redivo/tcc/doc/project/volume-final/volume-final.pdf

### George Redivo Pinto

# Equipamento para teste de transceptores ethernet

Porto Alegre, Rio Grande do Sul, Brasil

Novembro de 2013

### George Redivo Pinto

# Equipamento para teste de transceptores ethernet

Equipamento para automatizaçao de testes de ˜ equipamentos de rede dotados de transceptores SFP.

Orientador:

### Prof. Marcos Augusto Stemmer

PONTIFÍCIA UNIVERSIDADE CATOLICA DO ´ | RIO GRANDE DO SUL

Porto Alegre, Rio Grande do Sul, Brasil

Novembro de 2013

# Resumo

Durante o desenvolvimento de um sistema, varias etapas de teste s ´ | ao executadas a fim de ˜
garantir o correto funcionamento do mesmo. Em equipamentos destinados a aplicaçoes cr ˜ | íticas,
esses testes sao massivos, na tentativa de garantir que o equipamento, em hip ˜ | otese alguma, fuja ´
do comportamento especificado e esperado, quando em campo.

Equipamentos ethernet switch, alem de interagir com outros equipamentos de rede, como ´ hosts, roteadores e outros switches, podem possuir portas do tipo Small Form-factor Pluggable transceiver (SFP) e interagirem diretamente com eles. Idealmente, o processo de teste de equi-
pamentos com portas SFP deve incluir testes de inserçao e remoç ˜ | ao, o que, por sua vez, necessita ˜
de intervençao f ˜ | ísica. Essa intervençaõ e geralmente manual, o que acaba provocando um alto ´
índice de erros.
Nesse contexto, este Trabalho de Conclusao de Curso prop ˜ | oe um equipamento capaz de ˜
viabilizar a automatizaçao dos testes de SFP. Essa plataforma inclui um m ˜ | odulo de injeç ´ | ao de ˜
falhas. Em mais detalhes, a plataforma sera capaz de fazer a inserç ´ | ao e remoç ˜ | ao de dois SFPs ˜
diferentes em uma mesma porta do ethernet switch, alem da injeç ´ | ao de falhas no barramento I ˜

2C,
tudo controlado por comunicaçao serial, possibilitando assim a automatizaç ˜ | ao do processo como ˜
um todo.

A soluçao proposta foi validada em um equipamento de rede fornecido pela empresa Data- ˜
com Telematica. Neste sentido, foi realizado uma s ´ | erie de experimentos visando a validaç ´ | ao da ˜
soluçao proposta. ˜

# Abstract

During a product design, several steps are performed to guarantee the correct product operation. In equipment designed for critical applications, these tests are massively stressed, trying to guarantee that the equipment works according to specifications.

Ethernet switches, also may interact with other network equipment, like hosts, routers and another switches, could have Small Form-factor Pluggable transceiver (SFP) ports and may interact directly with these equipment. Ideally the test process on SFP ports must include SFP insertion and removing tests, which requires a physical intervention. This intervention, in general, is done manually, inserting a high human error probability.

This paper proposes an infrastructure to turn automatic SFP tests feasible, including a fault injection module. Detailing it, this equipment is capable to perform the insertion and removing of two different SFPs in a same ethernet switch’s port. It is also capable to do fault injection on I

2C bus, all of it controlled by a serial communication, turning possible the automation of this test process.

This solution was validated in a network equipment provided by Datacom Telematica. To ´ validate it, several tests was performed to guarantee the functionality of the features proposed in this paper.

# Sumario ´

Lista de Tabelas

Lista de Figuras

Lista de Siglas | p. 8
1 Introduçaõ | p. 9
2 Fundamentaçao Te ˜ | orica ´ | p. 12
2.1 I²C | | p. 12
2.2 Portas Ethernet | | p. 13
2.2.1 | Modelo OSI | | p. 13
2.2.2 | Portas físicas | | p. 14
2.2.3 | Configuraçao | ˜ | p. 15
2.3 SFPs | | p. 17
2.3.1 | Tipos de SFPs | | p. 17
2.3.2 | PHY | | p. 18
2.3.3 | Dispositivos Internos | | p. 20
2.4 Modelos de Falha | | p. 20
2.5 Tipos de Teste | | p. 22
2.6 Mecanismos de Injeçao de Falhas | ˜ | p. 23

3 Soluçao Proposta ˜ | | p. 26
3.1 Multiplexaçao de SFPs | ˜ | p. 27
3.2 Modulo de Injeç ´ | ao de Falhas | ˜ | p. 28
3.3 Implementaçao | ˜ | p. 28
3.3.1 | Arquitetura de Hardware | | p. 29
3.3.2 | Arquitetura de Sofware | | p. 34
4 Validaçao e Avaliaç ˜ | aõ | p. 38
4.1 Teste das PCBs | | p. 39
4.1.1 | Teste de Montagem | | p. 39
4.1.2 | Teste Funcional | | p. 39
4.2 Teste de Integraçao | ˜ | p. 39
4.2.1 | Multiplexaçao | ˜ | p. 40
4.2.2 | Injeçao de Falhas | ˜ | p. 40
4.3 Analise dos Resultados | ´ | | p. 41
5 Consideraçoes Finais ˜ | p. 42
Referencias Bibliogr ˆ | aficas ´ | p. 43

# Lista de Tabelas

2.1 Parametros de configuraç ˆ | ao de portas ˜ | ethernet | | p. 15

# Lista de Figuras

2.1 Barramento I²C | | p. 13
2.2 Comunicaçaõ pass-through entre switch e SFP | | p. 18
2.3 Comunicaçao atrav ˜ | es de um PHY combo | ´ | | p. 19
2.4 Comunicaçao atrav ˜ | es de um PHY interno ao SFP el ´ | etrico | ´ | p. 19
3.1 Operaçao normal entre ˜ | switch e SFP | | p. 26
3.2 Operaçao com intervenç ˜ | ao do ATE entre ˜ | switch e SFP | | p. 26
3.3 Visao geral do ATE | ˜ | | | p. 27

3.4 Monitoramento e injeçao de falhas nos acessos I ˜

| | 2C | | p. 29
3.5 Projeto de hardware | | p. 30
3.6 Imagem da HS-PCB | | p. 31
3.7 Imagem da LS-PCB | | p. 32
3.8 Imagem de blocos da LS-PCB | | p. 33

3.9 Ligaçao do I ˜

2C entre ATE, SFP e ethernet switch | | p. 33
3.10 Arquitetura do software | | p. 35

8

# Lista de Siglas

TCC Trabalho de Conclusao de Curso ˜

SFP Small Form-factor Pluggable

XFP 10 Gigabit Small Form-factor Pluggable

ATE Automatic Test Equipment, equipamento de teste automatico ´

MDIX Medium Dependent Interface crossover, interface cruzada dependente de mídia

MSA Multi-Source Agreement, acordo multi-fonte

OSI Open Systems Interconnection, sistema aberto de interconexoes ˜

CI Circuito Integrado

DD Digital Diagnostics, diagnosticos digitais

PCB Printed Circuit Board, placa de circuito impresso

HS-PCB High Speed PCB, PCB de alta velocidade

LS-PCB Low Speed PCB, PCB de baixa velocidade

BIST Built-In Self Tests

ACK acknowledgement

SoC System on Chip

ARM-DEV-KIT ARM Devetopment Kit, Kit de desenvolvimento ARM

SerDes Serializador/Desserializador

SGMII Serial Gigabit Media Independent Interface, Interface serial gigabit independente de

mídia

9

# 1 Introduçaõ

Com o aumento da complexidade dos sistemas atuais, a tarefa de teste e algo de extrema ´

importancia. Um teste, em linhas gerais, ˆ | e uma atividade na qual uma ou mais entradas s ´ | aõ
injetadas em um dado sistema e suas saídas sao analisadas, a fim de encontrar discrep ˜ | ancias ˆ

entre o comportamento especificado e o comportamento real do sistema.

Dependendo das características e dimensoes de um sistema, a tarefa de desenvolvimento ˜

pode se tornar bastante complexa (DELAMARO; MALDONADO; JINO, 2007), o que torna a

atividade de teste de um projeto algo crucial para garantir o bom funcionamento de um produto.

O teste pode ser feito em varios n ´ | íveis e estagios de produç ´ | ao de um sistema. Desde testes ˜
dos circuitos integrados (CIs) que compoe o sistema at ˜ | e testes em campo, utilizando ´ | Built-In Self
Tests, BISTs. E desej ´ | avel que um problema seja descoberto no est ´ | agio mais b ´ | asico poss ´ | ível, pois
o custo da resoluçao de um problema sobe conforme o n ˜ | ível em qual ele foi encontrado (WANG;

WU; WEN, 2006).

O teste de um projeto pode ser dividido em varias etapas. Entre elas est ´ | ao: (1) teste funcional, ˜
onde o projeto e testado a fim de garantir a conformidade com sua especificaç ´ | | | ao comportamental ˜

e (2) teste comportamental, onde o alvo do teste e excitado de forma a simular o uso real do equi- ´

pamento ou sistema, tentando encontrar falhas, para que elas sejam corrigidas antes do projeto

ser dado como pronto. Os estímulos do teste podem ser introduzidos manualmente, com uma

pessoa interagindo ativamente com o alvo do teste. Outra forma, e utilizando componentes auto- ´

matizadores de teste, onde um elemento pre programado interage com o alvo do teste, inserindo ´

os estímulos (HSUEH; TSAI; IYER, 1997). Esses componentes sao chamados equipamento de ˜

teste automatico, ATE, do ingl ´ | esˆ Automatic Test Equipment.
Existem tambem testes envolvendo injeç ´ | ao de falhas, no qual o equipamento ou sistema ˜ | é

10

testado em condiçoes anormais. Os testes com injeç ˜ | ao de falhas s ˜ | ao utilizados para observar o ˜
comportamento do alvo do teste em uma situaçao de falha tanto do pr ˜ | oprio projeto, quanto de ´

outros subsistemas envolvidos. Com os dados obtidos nos testes com injeçao de falhas pode-se ˜

medir, por exemplo, a robustez do projeto e se ele responde da forma esperada quando encontra

um estado de falha. As falhas podem ser introduzidas em diversos níveis, desde níveis mais

baixos, como curto circuitos, ate o n ´ | ível de usuario, como inserç ´ | ao de um valor inv ˜ | alido em um ´
campo de entrada. Esse tipo de teste e muito ´ | util em aplicaç ´ | oes cr ˜ | íticas, pois essas tem de se
manter sempre ativas, muitas vezes implementando modulos de toler ´ | ancia a falhas para evitar a ˆ
indisponibilidade do sistema. Aplicaçoes cr ˜ | íticas sao, por exemplo, sistemas de navegaç ˜ | ao de ˜

aeronaves, ou sistemas automatizados de controle de metro, os quais nunca podem parar, pois ˆ

causariam um prejuízo muito grande.

Os testes podem ser manuais ou automaticos, dependendo dos requerimentos do teste. Tes- ´

tes manuais tem diversas desvantagens quando comparados a testes autom ` | aticos, como menor ´

velocidade de execuçao do teste, tempo gasto com a aprendizagem de um novo procedimento, ˜

falta de consistencia e possibilidade de erro humano na execuç ˆ | ao das tarefas. Embora muitas das ˜

desvantagens sejam relacionadas apenas a requisitos temporais, a possibilidade de erro durante

a execuçao do roteiro de teste est ˜ | a relacionada ´ | a credibilidade do teste. Se, durante a execuç ` | aõ

de um teste manual, algum passo do roteiro for pulado, adicionado, ou executado de forma er-

rada, o teste pode apresentar resultados invalidos, tanto falsos positivos quanto falsos negativos. ´

Por todos esses motivos, o esforço gasto em automatizaçao de testes vem sendo cada vez maior, ˜

assim, os recursos humanos podem ser investidos em outras atividades mais produtivas, como o

aprimoramento dos casos de teste, ao inves de serem gastos na execuç ´ | ao dos mesmos. ˜

A atividade de teste, alem se ser a base um sistema livre de falhas, ajuda a desenvolver ´

estatísticas de rendimento do processo (WANG; WU; WEN, 2006). Assim, dependendo do nível

de detalhamento e poss ´ | ível identificar falhas de processo do projeto como um todo, desde a fase
de especificaçao at ˜ | e a fase de produç ´ | ao. ˜

Com o objetivo de flexibilizar o uso, alguns equipamentos de rede possuem portas de comunicaçaõ

com conector para a inserçao de um transceptor ( ˜ | transceiver) externo. Um transceiver, do ponto
de vista de redes de dados, e um dispositivo da camada f ´ | ísica, capaz de transmitir e receber da-
dos, fazendo a conversao dos sinais (sinais el ˜ | etricos em ´ | opticos, por exemplo) e/ou a convers ´ | aõ
da interface de comunicaçao. Com diferentes ˜ | transceivers, e poss ´ | ível, por exemplo, uma mesma

11

porta de comunicaçao ser utilizada com fibra ˜ | optica ou conetor RJ45. ´
A configuraçao aplicada na porta deve ser compat ˜ | ível com o transceptor inserido na mesma,
para evitar comportamentos inesperados. No entanto, devido a possibilidade de variadas configuraç ` | oes ˜
e modelos de transceptores, a configuraçao se torna algo extremamente delicado e suscet ˜ | ível a

erros.

Certos equipamentos sao capazes de configurar automaticamente a porta, baseando-se nas ˜

informaçoes obtidas do transceptor. A dificuldade da autoconfiguraç ˜ | aõ e agravada pelo fato de ´
existir uma grande gama de combinaçoes entre configuraç ˜ | ao e modelo de transceptor. Al ˜ | em´
disso, existem casos onde equipamentos sao logicamente empilhados ( ˜ | stacking¹
).

Em um ambiente de staking, podem existir diversos equipamentos com características dife-

rentes, o que dificulta a configuraçao destes. ˜

Durante o processo de teste dos trasnceivers, se faz necessario a conex ´ | ao e/ou desconex ˜ | aõ

física dos mesmos, geralmente manual, trazendo os riscos e desvantagens ja citadas anterior- ´

mente. A automatizaçao desses procedimentos resulta em um grande acr ˜ | escimo na produtivi- ´

dade e confiabilidade do teste, porem isso introduz um elemento a mais no ambiente de testes, ´

um ATE.

Este TCC propoe um soluç ˜ | ao baseada em ˜ | hardware e software que permite a automatizaçaõ

de testes de equipamentos ethernet dotados de transceptores SPFs. Como estudo de caso foram

utilizados transceptores SPFs em switches ethernet.

1Do ponto de vista de equipamentos de rede, quando monta-se um ambiente onde varios equipamentos s ´ | aõ
ligados uns aos outros, de forma a se tornarem virtualmente um equipamento so, com capacidade somada e controle ´ centralizado, denomina-se um ambiente stacking.

12

2 | Fundamentaçao Te ˜ | orica ´
Dentro do universo de redes de dados existem inumeras distinç ´ | oes entre tipos de equipamen- ˜
tos, funcionalidades e configuraçoes. O cen ˜ | ario escolhido para o estudo ´ | e o de equipamentos ´

ethernet dotados de portas SFPs.

## 2.1 I²C

Desenvolvido pela Philips (atual NXP), nos anos 80, a comunicaçao I ˜

2C e uma comunicaç ´ | aõ

em barramento, que utiliza dois fios para trafego de dados serial. Usando uma estrutura mestre- ´

escravo, e poss ´ | ível a comunicaçao entre v ˜ | arios dispositivos utilizando apenas dois fios, em dreno ´
aberto: um fio de clock e um de dados, chegando a taxa de transfer ` | encia de 3,4Mbps (I2C- ˆ
BUS.ORG, 2013). Devido a simplicidade e versatilidade de implementaç ` | ao, o I ˜

2C e largamente ´

usado em comunicaçoes simples que n ˜ | ao exigem alta taxa de transfer ˜ | encia de dados. ˆ

A comunicaçao I ˜

2C se da atrav ´ | es de um barramento onde ficam conectados um dispositivo ´
mestre e ate 127 dispositivos escravos (figura 2.1). O dispositivo mestre n ´ | ao possui endereço. ˜

Os dispositivos escravos possuem um endereçamento de 7 bits, podendo endereçar 127 dispo-

sitivos. O endereço 0 e utilizado como endereço geral, uma especie de endereço de ´ | broadcast.

Existe tambem um modo de endereçamento de 10 bits, o que aumenta a quantidade de endereços ´

disponíveis.

Em linhas gerais, a comunicaçao se d ˜ a da seguinte forma: (1) mestre informa ao barramento ´

que deseja se comunicar com um dispositivo informando seu endereço; (2) o dispositivo escravo

responde um acknowledgement (ACK); (3) mestre informa registrador interno com o qual deseja

se conectar; (4) escravo responde dado referente ao registrador interno, em caso de leitura, ou

13

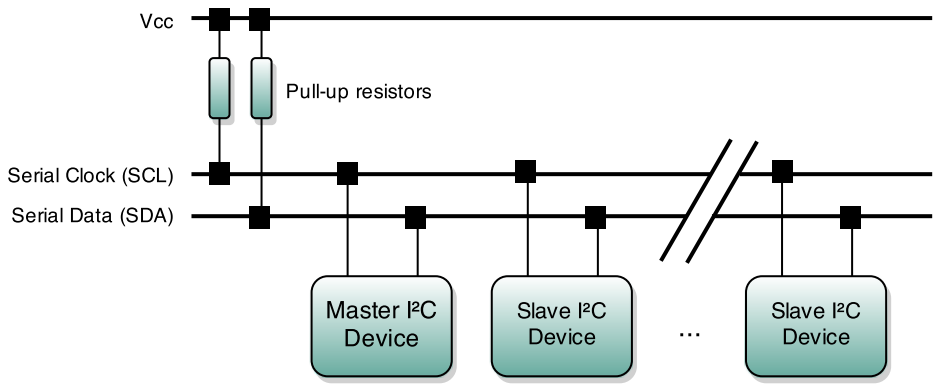
[picture p7: figure]

Figura 2.1: Barramento I²C

faz a atribuiçao em caso de escrita. ˜

## 2.2 Portas Ethernet

A ethernet e uma arquitetura de rede de dados largamente utilizada. Ela ´ | | e normatizada pela ´

IEEE 802.3, que descreve todos os detalhes da arquitetura. As portas de um equipamento ether-

net podem ser de tipos variados e ter configuraçoes distintas. Esta sess ˜ | ao destina-se a detalhar as ˜

principais características das portas ethernet.

### 2.2.1 Modelo OSI

O Modelo OSI (Open Systems Interconnection, sistema aberto de interconexoes) ˜ | e uma das ´
mais antigas e mais usadas arquiteturas de comunicaçao entre m ˜ | aquinas. Este modelo divide a ´
comunicaçao em 7 camadas hier ˜ | arquicas. Cada camada tem uma funç ´ | ao bem definida dentro ˜

da comunicaçao e consegue se comunicar apenas com as camadas adjacentes. Essa propriedade ˜

modulariza a comunicaçao de forma a diminuir a complexidade da comunicaç ˜ | | ao como um todo. ˜

As camadas sao divididas da seguinte maneira: ˜

Aplicaçaõ
A camada de aplicaçaõ e a camada de mais alto n ´ | ível. E nela que ficam os ´ | softwares como

navegadores de internet e clientes de e-mail.

14

Apresentaçaõ

Esta camada e respons ´ | avel pela formataç ´ | ao e convers ˜ | ao dos dados. ˜

Sessaõ

A camada de sessao gerencia o fluxo de dados, sendo respons ˜ | avel por tratamento de erros ´

dessa natureza.

Transporte
E respons ´ | avel pela entrega e recebimento dos dados, tentando garantir a confiabilidade de ´

transmissao. ˜

Rede

Esta camada faz o roteamento dos pacotes, escolhendo a melhor rota, baseando-se em

metricas como congestionamento e custo do caminho. ´

Enlace

A camada de enlace e o elo entre a camada f ´ | ísica e a camada de rede. Ela e respons ´ | avel ´

pela configuraçao de fluxo de dados e pela topologia de rede. ˜

Física

Esta e a camada de mais baixo n ´ | ível, onde os sinais logicos e el ´ | etricos s ´ | ao convertidos e ˜

enviados.

Este trabalho atua nas duas camadas de nível mais baixo: camada física e de enlace.

### 2.2.2 Portas físicas

As portas de um equipamento ethernet servem para fazer a ligaçao entre dois dispositivos em ˜

uma rede ethernet. Diversos conectores ja foram usados em aplicaç ´ | oes ˜ | ethernet e o mais comum
e o conector RJ45, o qual ´ | e usado para fazer a ligaç ´ | ao com um par trançado ˜

1
. Com o desen-
volvimento da tecnologia optica, os cabos de fibra ´ | optica vem se popularizando, principalmente ´
em aplicaçoes de alta frequ ˜ | encia e aplicaç ˆ | oes de longa dist ˜ | ancia. A fibra ˆ | optica, por usar a luz, ´
1Par trançado e um tipo de cabeamento onde dois fios, contendo sinais diferenciais, s ´ | | | | ao enrolados um ao redor ˜
do outro, a fim de diminuir a suscetibilidade a interfer ` | encias eletromagn ˆ | eticas. Cabos ´ | ethernet do padrao CAT 6, ˜
por exemplo, contem 4 pares trançados.

15

pode trabalhar em frequencias muito altas, tem baixo n ˆ | ível de perda de sinal e suscetibilidade
a interferencia. Por outro lado, o cabo el ˆ | etrico, apesar de n ´ | ao possuir tantas vantagens, chega a ˜
1Gbps e distancias de at ˆ | e 100 metros por um custo bem inferior ´ | a fibra ` | optica. ´

Como foi citado no capítulo 1, existem equipamentos com portas as quais seu conector naõ

e nem para fibra ´ | optica, nem para RJ45, mas sim conector para algum ´ | transceiver. Desta forma,

uma mesma porta pode ser usada com cabeamento de fibra optica ou par trançado, dependendo ´

do transceptor conectado. Em aplicaçoes ˜ | ethernet, os transceptores mais comumente usados saõ
os SFPs e XFPs. SFPs sao geralmente usados para aplicaç ˜ | oes de rede ˜ | Gigabit Ethernet, enquanto
XFPs sao usando para aplicaç ˜ | oes de 10 ˜ | Gigabit Ethernet.

### 2.2.3 Configuraçaõ

Cada porta ethernet deve receber uma serie de configuraç ´ | oes para que tenha uma operaç ˜ | aõ
estavel. Essas configuraç ´ | oes ditam desde o ˜ | bit rate, ate configuraç ´ | oes de invers ˜ | ao de TX e RX. ˜
Os parametros mais comuns de configuraç ˆ | ao de uma porta ˜ | ethernet estao listados na tabela 2.1. ˜
Tabela 2.1: Parametros de configuraç ˆ | ao de portas ˜ | ethernet
Parametro ˆ | Descriçaõ
Velocidade | 1 Informa a velocidade do trafego na porta. ´
Speed Capabilities | Informa as configuraçoes de velocidade poss ˜ íveis para a porta.²
Duplex | 1 Informa se a conexaõ é Full Duplex ou Half Duplex.
Duplex Capabilities | Informa as configuraçoes de ˜ duplex possíveis para a porta.²
Negociaçaõ | Informa se os parametros de ˆ duplex e velocidade serao forçados ou ne- ˜ gociados, utilizando as capabilities.
MDIX | Informa se a ligaçao de TX e RX est ˜ a normal, invertida ou se ser ´ a con- ´ figurada automaticamente.³
Habilitaçaõ | Informa se a porta esta habilitada ou desabilitada. ´
1Configuraçao v ˜ | alida apenas quando auto negociaç ´ | ao est ˜ | a desabilitada. ´
2Configuraçao v ˜ | alida apenas quando auto negociaç ´ | ao est ˜ | a habilitada. ´
3MDIX automatico funciona apenas quando auto negociaç ´ | ao est ˜ | a habilitada, caso contr ´ | ario o MDIX per- ´
manece com o status anterior.
Existe ainda uma configuraçao referente ao protocolo de comunicaç ˜ | ao usado entre a camada ˜
física e a camada de enlace. Essa configuraçao geralmente ˜ | e transparente para o usu ´ | ario da ´
porta, ao contrario das configuraç ´ | oes listadas na tabela 2.1. A escolha de qual protocolo utilizar ˜

16

depende do protocolo utilizado pelo dispositivo parceiro ligado a porta. Dois protocolos nor- `

malmente sao utilizados: (1) SerDes (Serializador/Desserializador) e (2) SGMII ( ˜ | Serial Gigabit

Media Independent Interface)

2
. Os dois sao protocolos de comunicaç ˜ | ao serial. O protocolo Ser- ˜
Des e geralmente utilizado em conex ´ | oes diretas, onde n ˜ | ao existe um PHY intermedi ˜ | ario (ver sub ´
sessao 2.3.2), caso contr ˜ | ario utiliza-se o protocolo SGMII. ´
As configuraçoes a serem feitas dependem de diversos fatores como aplicaç ˜ | ao, tipo de cabo, ˜
tipo de conexao e suporte ˜ | as configuraç ` | oes por parte das duas pontas da conex ˜ | ao, da porta e, em ˜
caso de uso de transceivers, suporte as configuraç ` | oes por parte dos ˜ | transceivers.
Devido a essa variabilidade, a parte do sistema que executa as configuraçoes ˜ | e extremamente ´
sensível. Em casos onde existe um transceptor na porta, essa sensibilidade e acentuada, pois al ´ | em´
do suporte de configuraçao das portas dos dois lados da conex ˜ | ao, a configuraç ˜ | ao ainda precisa ˜
ser coerente com o transceptor. Durante o funcionamento do equipamento, e poss ´ | ível trocar o

transceiver de uma determinada porta por outro com características diferentes, o que faz com

que configuraçoes diferentes devam ser escolhidas e aplicadas, dependendo das especificaç ˜ | oes ˜

do transceptor.

Exitem ainda equipamentos com portas chamadas portas combo. Essas portas sao replicadas. ˜

Para flexibilizar as aplicaçoes do equipamento, cada porta combo ˜ | e dotada de um conector SFP ´
e um conector RJ45, porem os dois conectores n ´ | ao podem ser usados simultaneamente. Essas ˜
portas sao configuradas de maneira completamente diferente em cada meio (meio ˜ | optico, SFP, e ´
meio eletrico, RJ45), o que torna a configuraç ´ | ao de portas combo ainda mais sens ˜ | ível a erros.
Com essa dinamica, a configuraç ˆ | ao de portas pode se tornar algo complexo, em especial em ˜
casos onde o equipamento e provido de um m ´ | odulo de auto configuraç ´ | ao. Essas caracter ˜ | ísticas
tornam o teste de configuraçao e troca de transceptores uma tarefa cr ˜ | ítica, pois existem inumeras ´
combinaçoes de configuraç ˜ | ao poss ˜ | íveis, tornando o teste uma tarefa longa e um bom alvo para

ser automatizado.

2SGMII e um protocolo de comunicaç ´ | ao criado pela Cisco com o objetivo de viabilizar a utilizaç ˜ | ao entre a ˜
camada MAC e PHYs 10/100/1000 com o mínimo possível de perda de sinal (CISCO SYSTEMS, 2005).

17

## 2.3 SFPs

SFP (Small Form-factor Pluggable) e um tipo de transceptor, um modelo de tamanho f ´ | ísico
pequeno, utilizado para conexoes de baixa e m ˜ | edia velocidade (abaixo de 10Gbps). Existem ´
diversos tipos de SFPs. Os SFPs dividem-se basicamente em SFPs eletricos e SFPs ´ | opticos, os ´

quais mais comumente usam conectores RJ45 e LC, respectivamente.

Os SFPs sao descritos por dois MSA ( ˜ | Multi-Source Agreement), INF-8074 e SFF-8472.
Esses documentos definem como devem ser as características mecanicas, el ˆ | etricas e l ´ | ogicas, ´
como dimensoes, imped ˜ | ancias e endereçamento das informaç ˆ | oes. Como esses documentos n ˜ | aõ

sao uma norma oficial, apenas um acordo entre alguns dos grandes fabricantes desses equipa- ˜

mentos, existe a possibilidade de alguns modelos nao seguirem as recomendaç ˜ | oes. Isso torna ˜
a configuraçao das portas envolvendo SFPs mais dif ˜ | ícil e perigosa. SFPs que nao seguem as ˜

especificaçoes dos MSAs podem apresentar comportamentos indefinidos. Por esse motivo al- ˜

guns fabricantes de equipamentos que usam SFPs tem uma política de homologaçao de SFPs e ˜

bloqueio de SFPs nao homologados. ˜

Cada SFP possui pelo menos um dispositivo interno acessado por I²C.

O dispositivo basico, acessado pelo endereço 0x50 (SFF COMMITTEE, 2013), comum ´ | à
todos os SFPs, e um bloco de mem ´ | oria onde ficam gravadas as informaç ´ | oes sobre o SFP. Esse ˜
bloco de memoria guarda informaç ´ | oes como nome do fabricante, n ˜ | umero de s ´ | erie, tipo conector, ´
taxa maxima de transmiss ´ | ao e outros dados referentes ao SFP, bem como c ˜ | odigos de checagem. ´
Alem do dispositivo b ´ | asico, o SFP pode conter outros dispositivos adicionais acessados por ´

I

2C, tais como modulo de diagn ´ | ostico digital (DD, ´ | Diagital Diagnostics), e PHY interno do SFP.
Cada dispositivo e acessado atrav ´ | es de um endereço I ´

2C diferente.

### 2.3.1 Tipos de SFPs

Entre todos os modelos de SFPs existem dois grandes grupos: os SFPs eletricos e os SFPs ´

opticos. Dentro desses grupos existem outras subdivis ´ | oes. As divis ˜ | oes s ˜ | ao feitas a fim de separar ˜
os SFPs por taxa de transferencia, possibilidade de negociaç ˆ | ao, ˜ | capabilities e, especificamente
para SFPs opticos, existem divis ´ | oes de comprimento de onda e dist ˜ | ancia m ˆ | axima (pot ´ | encia) do ˆ

18

laser.

Os variados tipos de SFPs necessitam de configuraçoes diferentes, alguns suportam mais ˜

configuraçoes que outros. Isso faz com que, em caso de auto configuraç ˜ | ao, de alguma forma, ˜
o equipamento que esta hospedando o SFP deva conseguir descobrir informaç ´ | oes pertinentes ˜
as configuraç ` | oes e fazer a correta aplicaç ˜ | ao dessas configuraç ˜ | oes. Essas informaç ˜ | oes est ˜ | ao dis- ˜

postas em um memoria dentro do SFP, acessada por I ´

| | | 2C, cujo mapeamento e descrito pelos ´

documentos INF-8074 e SFF-8472 (SFF COMMITTEE, 2001) (SFF COMMITTEE, 2013).

A maioria dos SFPs opticos com taxa de transfer ´ | encia na casa de 1Gbps fazem uma passa- ˆ
gem direta (pass-through) na comunicaçao com o ˜ | switch, atraves do modo SerDes (figura 2.2), ´
utilizando o PHY (melhor detalhado em 2.3.2) do proprio ´ | switch para fazer as configuraçoes, ˜
apenas transformando o sinal optico em sinal el ´ | etrico e vice-versa. J ´ | a os SFPs el ´ | etricos e alguns ´
100Mbps opticos possuem um PHY interno, o qual deve ser configurado com os par ´ | ametros ˆ
vistos na tabela 2.1, alem da configuraç ´ | ao do pr ˜ | oprio ´ | switch.

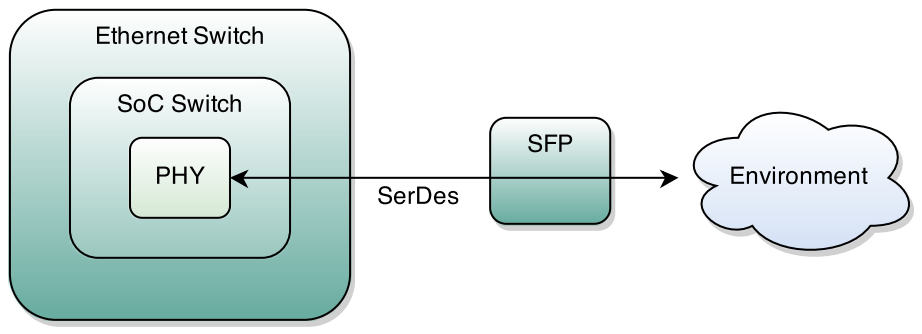
[picture p8: figure]

Figura 2.2: Comunicaçaõ pass-through entre switch e SFP.

### 2.3.2 PHY

PHY, do inglesˆ physical, do ponto de vista de redes ethernet, e um dispositivo que trabalha ´

na camada física do modelo OSI, capaz de fazer a conversao de sinais anal ˜ | ogicos em digitais, e ´
vice-versa, enviando e recebendo frames ethernet (PHY, 2013). Alem das configuraç ´ | oes citadas ˜
na tabela 2.1, alguns PHYs dispoes de configuraç ˜ | oes e informaç ˜ | oes mais espec ˜ | íficas, como tipo
de mídia, protocolo de comunicaçao e invers ˜ | ao de trilhas. ˜

Esses dispositivos podem ser um CI separado, ou estar integrado em um CI com mais funci-

19

onalidades. O trafego de uma porta ´ | ethernet pode passar por mais de um PHY, mesmo antes de

sair do equipamento origem. Isso acontece em casos de portas combo, por exemplo, onde alem´

de o trafego passar pelo PHY integrado no SoC ( ´ | System on Chip) do switch, pode passar por mais
um PHY, que e respons ´ | avel de escolher qual meio (porta el ´ | etrica ou porta SFP) ser ´ | a enviado ou, ´
em caso de recebimento, qual porta sera escutada, como mostra a figua 2.3. Outro caso onde h ´ | á
mais de um PHY envolvido, e em ocasi ´ | oes em que usamos SFPs com PHY embarcado (figura ˜
2.4), como explicado na sessao 2.3.1, onde esse PHY ˜ | e acessado atrav ´ | es de uma comunicaç ´ | aõ

I

2C com o SFP. Nesses casos existe um PHY para fazer a comunicaçao do ˜ | switch ate o SFP e ´
outro PHY, embarcado no SFP, que faz a comunicaçao at ˜ | e o outro lado da conex ´ | ao. ˜

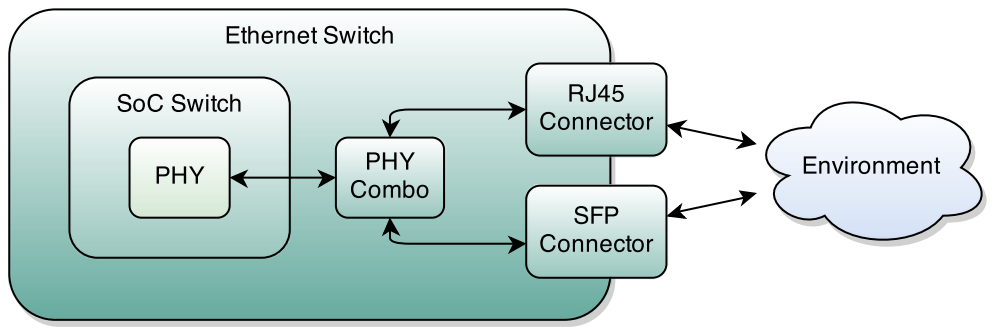
[picture p9: figure]

Figura 2.3: Comunicaçao atrav ˜ | es de um PHY combo. ´

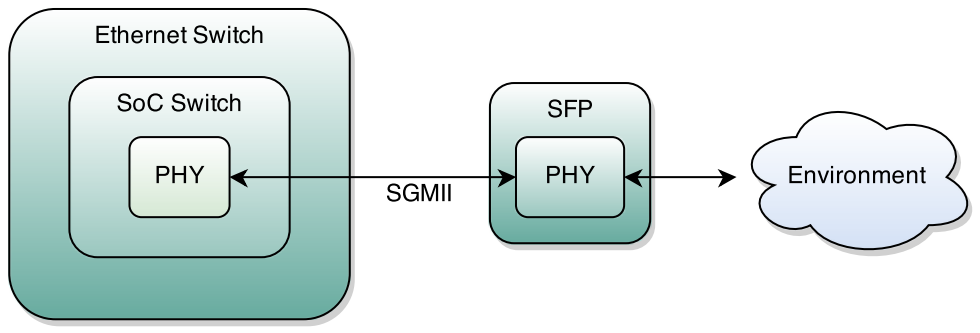
[picture p10: figure]

Figura 2.4: Comunicaçao atrav ˜ | es de um PHY interno ao SFP el ´ | etrico. ´

Em todos os casos onde existe mais de um PHY em um mesmo lado da comunicaçaõ é

necessario fazer a correta configuraç ´ | ao de todos os PHYs. Essas configuraç ˜ | oes podem variar ˜

de caso para caso, dependendo de características estaticas, como da arquitetura do equipamento, ´

e características dinamicas, como a topologia de rede e aplicaç ˆ | ao no qual o equipamento em ˜

20

questao est ˜ a sendo utilizado. ´

### 2.3.3 Dispositivos Internos

Os SFPs sao providos basicamente de uma mem ˜ | oria interna. Essa mem ´ | oria guarda informaç ´ | oes ˜
sobre o SFP, como nome do fabricante, codigo do produto e n ´ | umero de s ´ | erie, al ´ | em de dados per- ´
tinentes a auto configuraç ` | ao, como taxa m ˜ | axima de dados e ´ | Ethernet Standard.
As informaçoes disponibilizadas na mem ˜ | oria do SFP s ´ | ao a base para decis ˜ | oes de autoconfiguraç ˜ | aõ
dos equipamentos hospedeiros de SFPs. E na mem ´ | oria que est ´ | a toda a informaç ´ | ao est ˜ | atica ´
acessível. A disposiçao das informaç ˜ | oes da mem ˜ | oria dos SFPs s ´ | ao descritas pelos MSAs ci- ˜
tados no capítulo 2.3, mas como foi dito anteriormente, visto que os MSAs nao s ˜ | ao normas, os ˜
SFPs podem ou nao seguir essas recomendaç ˜ | oes. ˜
Ainda existem areas de mem ´ | oria espec ´ | íficas para o vendedor do SFP. Essas areas possibi- ´
litam o vendedor gravar informaçoes como nome do vendedor, ˜ | part number específico usado
pelo vendedor e quaisquer outras informaçoes, como c ˜ | odigo de homologaç ´ | ao, ou informaç ˜ | oes ˜
adicionais para a identificaçao do m ˜ | odulo SFP. ´
Alguns SFPs sao providos de um m ˜ | odulo DD, especificado pela SFF-8472, que ´ | e um sis- ´

tema de monitoramento do status do SFP. O DD guarda informaçoes como temperatura do SFP, ˜

potencia do ˆ | laser (TX e RX) e tensao de alimentaç ˜ | ao. Esses dados s ˜ | ao lidos em tempo real e ˜

acessados atraves de um dispositivo I ´

2C específico. Lendo informaçoes de DD ˜ | e poss ´ | ível ter um
relatorio da sa ´ | ude do SFP, o que pode ser usado para executar aç ´ | oes de prevenç ˜ | ao ou simples- ˜

mente como um informativo ao usuario. ´

## 2.4 Modelos de Falha

Em um sistema eletronico problemas podem ocorrer em v ˆ | arias ´ | areas e em v ´ | arios n ´ | íveis de
abstraçao. Quando se deseja trabalhar na descoberta, ou injeç ˜ | ao de algum tipo de problema, ˜ | | | é
necessario entender em que n ´ | ível esta e como o problema ocorre. ´

Primeiramente deve-se entender a diferença entre tres termos que podem facilmente ser con- ˆ

fundidos: defeito, erro e falha. Michael L. Bushnell e Vishwani D. Agrawal (BUSHNELL;

21

AGRAWAL, 2000) fazem a seguinte definiçao acerca desses termos: ˜

- Defeito e uma discrep ´ | ancia, em ˆ | hardware, entre o sistema implementado e seu respectivo

projeto.

- Erro e uma sa ´ | ída errada produzida por um sistema defeituoso.
- Falha e a representaç ´ | ao de um err, em um n ˜ | ível de abstraçao funcional. ˜
A definiçao do autor ˜ | e voltada para ´ | hardware, mas tambem podemos adapta-la para um sis- ´

tema híbrido, onde hardware e software coexistem. Nesse contexto, o defeito seria um problema

na construçao (f ˜ | ísica, ou logica), um erro seria a sa ´ | ída errada, produzida pelo defeito, e a falha
seria a manifestaçao do erro, por ˜ | em em um n ´ | ível observavel pelo usu ´ | ario. ´
Assim como o projeto de um sistema, as falhas sao modeladas em n ˜ | íveis hierarquicos. Os ´
níveis mais baixos apresentam maiores detalhes sobre o as falhas, porem com a modularizaç ´ | aõ

pode-se ter uma compreensao maior. ˜

O nível físico e o n ´ | ível basico, conhecido tamb ´ | em como n ´ | ível de componente. Nesse nível

ficam os problemas de curtos circuitos e circuitos abertos.

Intermediariamente existe o nível logico, no qual as falhas s ´ | ao modeladas a n ˜ | ível de portas
logicas. Aqui temos falhas de ´ | stuck-ats, falhas de temporizaçao, entre outras. ˜
O nível mais alto e o n ´ | ível comportamental. Esse nível representa falhas funcionais do
sistema. Falhas de comunicaçao podem ser representadas nesse n ˜ | ível.
A injeçao de falhas abordada nesse estudo ˜ | e no n ´ | ível comportamental, por ser falha de

comunicaçao I ˜

2C. Falhas nesse nível nao necessariamente s ˜ | ao a n ˜ | ível eletrico. Elas podem ser ´
modeladas de acordo com a aplicaçao em quest ˜ | ao (BUSHNELL; AGRAWAL, 2000). ˜
As falhas podem estar associadas a um barramento, ` | a um pino de um CI ou at ` | e mesmo a uma ´
interferencia oriunda do ambiente. Al ˆ | em disso, as falhas podem ser permanentes ou transiente. ´
Falhas permanentes sao causadas por um dano f ˜ | ísico em algum componente do sistema. Esse

dano pode ser proveniente do processo de fabricaçao ou do desgaste do uso do sistema. Falhas ˜

transientes acontecem por algum tempo e desaparecem, podendo voltar a ocorrer.

22

Neste estudo, a injeçao de falhas feita foi falha de comunicaç ˜ | ao, por ˜ | em o ATE desenvolvido ´
tem capacidade de implementar outras falhas como falhas de temporizaçao na comunicaç ˜ | ao, ˜
alem de ´ | stuck-ats dos fios do barramento I²C.

## 2.5 Tipos de Teste

A atividade de desenvolvimento de um sistema e uma tarefa complexa e est ´ | a sujeita a uma ´
serie de problemas. Esses problemas s ´ | ao inerentes ao desenvolvimento de um projeto, e eles ˜
ocorrerao mesmo com a utilizaç ˜ | ao de m ˜ | etodos e ferramentas de engenharia (DELAMARO; ´

MALDONADO; JINO, 2007). No desenvolvimento de um produto de alta qualidade, varias ´

etapas de testes sao executadas, a fim de garantir a qualidade do projeto. Quanto mais cr ˜ | | | ítica e a ´
aplicaçao do projeto a ser desenvolvido, mais se faz necess ˜ | ario boas t ´ | ecnicas de testes, visando ´

o maior coeficiente de cobertura de falhas.

Ao contrario do que muitos pensam, o objetivo do teste n ´ | aõ e provar que um sistema n ´ | aõ

possui falhas, mas sim encontrar as falhas que tal sistema possui, antes desse ser dado como

pronto. Quanto mais cedo um problema for detectado, menos custosa sera a correç ´ | ao deste. ˜
Suponhamos que foi detectado um serio problema arquitetural em um dado CI. Caso este CI j ´ | á
tenha sido vendido, dependendo da criticidade de sua tarefa, sera necess ´ | ario trocar as unidades ´

que foram vendidas. Por outro lado, se o problema for descoberto na fase de projeto, o CI passará

por um processo de correçao, sem necessidade de um ˜ | recall.
Com o aumento da complexidade dos sistemas, podem ser necessarios testes em v ´ | arias etapas ´
do desenvolvimento de um produto. Os teste vao desde a etapa de especificaç ˜ | ao, que verifica se ˜
as especificaçoes s ˜ | ao coerentes com o que se espera do projeto, at ˜ | e a n ´ | ível de aplicaçao, onde ˜
sao verificadas funcionalidades a n ˜ | ível de usuario. ´
Mesmo apos um produto ser criado, produzido e vendido, pode ser necess ´ | ario a avaliaç ´ | aõ
constante das condiçoes do produto. Nesses casos, durante a etapa de projeto, s ˜ | ao previstos ˜
mecanismos de detecçao de falhas, que s ˜ | ao embarcados no sistema (BISTs). Esses testes podem ˜

ser do modo online ou offline. Os testes online sao executados durante o funcionamento do ˜

sistema, enquanto os offline param a execuçao do sistema, ou s ˜ | ao rodados em momentos em ˜
que o sistema nao est ˜ | a ativo, como na inicializaç ´ | ao ou encerramento de um ciclo de atividades. ˜

23

Um exemplo classico desse tipo de teste ´ | e o teste de mem ´ | oria, que faz um auto teste durante a ´

inicializaçao do sistema. ˜

Entre os testes executados antes da venda de um produto, esta o teste funcional, o qual ´ | é

abordado neste estudo. O teste funcional tem por objetivo encontrar falhas em requisitos funcio-

nais do projeto, verificando inconsistencias entre a especificaç ˆ | ao e a execuç ˜ | ao real de um sistema. ˜
Para que esse tipo de teste seja realizado com a maior eficiencia poss ˆ | ível, e necess ´ | ario conhecer ´
a arquitetura do sistema. Com esse conhecimento e poss ´ | ível gerar casos de teste que excitem

partes sensíveis do projeto, ou seja, casos de teste que possuam a maior probabilidade de revelar

erros possível.

Por vezes, e necess ´ | ario mais do que apenas entradas de usu ´ | ario para que os casos de teste ´
tenham uma cobertura de falhas aceitavel. Dependendo da ´ | area que se quer excitar, ´ | e necess ´ | ario ´
fazer variaçoes de temperatura, incid ˜ | encia de ru ˆ | ídos e ate mesmo injeç ´ | ao artificial de falhas, o ˜
que sera visto no cap ´ | ítulo 2.6.

## 2.6 Mecanismos de Injeçao de Falhas ˜

Equipamentos tolerantes a falhas sao equipamentos capazes de contornar ou se recuperar de ˜

um determinado conjunto de falhas. Esses equipamentos devem conseguir, de alguma forma,

detectar falhas e se recuperar delas.

Alguns equipamentos tolerantes a falhas conseguem se recuperar e partir do estado imedi-

atamente anterior a falha ( ` | forward recovery). Outros, ao se recuperar, voltam a um ponto pré
determinado (backward recovery), como um reset. Forward recovery e um m ´ | etodo mais cus- ´
toso, pois e mais complexo que o ´ | backward recovery, porem proporciona um menor tempo de ´

indisponibilidade.

Muitas vezes o teste de equipamentos tolerantes a falhas naõ e trivial. Isso se d ´ | a pelo simples ´
fato de que as falhas nao ocorrem frequentemente. Em vista disso, s ˜ | ao desenvolvidos mecanis- ˜

mos de injeçao de falhas, que tem por objetivo injetar artificialmente falhas, a fim de avaliar a ˜

efetividade dos mecanismos de tolerancia a falhas de um dado equipamento ou sistema (HSUEH; ˆ

TSAI; IYER, 1997).

24

Com injeçao de falha, o sistema sobre teste se comporta como se tivesse um problema de ˜

fabricaçao ou comportamental (HSUEH; TSAI; IYER, 1997). Em caso de problema comporta- ˜

mental, o comportamento falho injetado e definido atrav ´ | es de estat ´ | ísticas e conhecimento previo ´

sobre o funcionamento falho do sistema. Quando a injeçao se trata de um problema no processo ˜

de fabricaçao, como curtos circuitos, circuitos abertos ou ˜ | stuck-ats, a injeçao feita ˜ | e baseada em ´
uma analise estrutural dependente do n ´ | ível de abstraçao da injeç ˜ | ao a ser feita. ˜
Os testes envolvendo injeçao de falhas podem ser feitos basicamente em dois n ˜ | íveis: injeçaõ
de falhas baseado em simulaçao e baseado em prot ˜ | otipo. Injeç ´ | ao de falhas baseada em simulaç ˜ | oes ˜
e utilizada na etapa de projeto de um sistema, onde o sistema ainda n ´ | ao existe de fato. J ˜ | a a injeç ´ | aõ
de falhas baseada em prototipo ´ | e executada com o sistema real, na sua fase de teste. (HSUEH; ´

TSAI; IYER, 1997)

Os mecanismos de injeçao de falhas podem ser divididos em tr ˜ | es tipos: baseados em ˆ | hard-

ware, baseados em software ou híbridos.

Os mecanismos baseados em hardware sao sistemas f ˜ | ísicos adicionais ou alteraçoes do ˜ | hard-

ware do projeto alvo de testes. Eles visam injetar artificialmente um determinado conjunto de

falhas. Essas falhas podem ser fenomenos como curtos circuitos, circuitos abertos, flutuaç ˆ | ao de ˜
tensao de alimentaç ˜ | ao, entre outros. ˜
Quando baseada em software, a injeçao de falhas pode ser feita alterando o c ˜ | odigo a n ´ | ível de
compilaçao, com ˜ | #ifdefs, da linguagem C, por exemplo, o que faz com que a injeçao de falhas ˜
seja estatica. Outra forma, ´ | e adotar uma abordagem, ainda em ´ | software, onde as falhas podem
ser controladas em tempo de execuçao. Essa soluç ˜ | ao implica em uma maior intrus ˜ | ao no ˜ | software

“real”, o que pode introduzir problemas nao existentes ou mascarar falhas existentes no projeto ˜

original, podendo causar falsos positivos e/ou falsos negativos.

A soluçao h ˜ íbrida adota as duas abordagens. hardware e software, em conjunto.

Enquanto mecanismos em hardware podem ter um alto custo de tempo e de recursos finan-

ceiros, devido ao fato de ele necessariamente precisar ser construído, os mecanismos baseados

em software geralmente exigem apenas custo de tempo. Porem, os mecanismos baseados em ´

hardware geralmente oferecem um risco de distorçao de resultado muito menor que os basea- ˜

dos em software. Isso ocorre pelo fato de que quando um modulo extra ´ | e introduzido no ´ | soft-

25

ware, o comportamento do sistema como um todo sofre uma perturbaçao ativa, proveniente dessa ˜

modificaçao, que pode alterar sua resposta. ˜

Alem das quest ´ | oes como custo e perturbaç ˜ | ao no sistema, antes da escolha de qual abordagem ˜
seguir e necess ´ | ario conhecer bem qual o tipo de falhas se deseja injetar. Algumas falhas simples- ´
mente nao podem ser injetadas por uma das abordagens. Por exemplo, uma falha de flutuaç ˜ | | | | ao de ˜
tensao n ˜ | ao pode ser injetada em ˜ | software, assim como valores invalidos em um campo de entrada ´
nao podem ser injetados atrav ˜ | es de ´ | hardware.
Existem tambem ocasi ´ | oes onde o mais adequado ˜ | e a soluç ´ | ao h ˜ | íbrida, usando as duas meto-

dologias para implementar diferentes partes do mecanismo de injeçao de falhas. ˜

26

# 3 Soluçao Proposta ˜

Como soluçao para a dificuldade de automatizaç ˜ | | ao de testes com SFPs, este trabalho prop ˜ | oẽ
um ATE, baseado em prototipo (ler sess ´ | ao 2.6), utilizando metodologia h ˜ | íbrida (hardware e

softwate), que funciona como um mediador entre os SFPs e o equipamento hospedeiro de SFPs,

implementando um modulo de injeç ´ | ao de falhas e um multiplexador de SFPs, que ser ˜ | ao detalha- ˜

dos neste capítulo.

Em uma ligaçao normal, o SFP ˜ | e ligado diretamente ao ´ | switch (figura 3.1), e entao ligado ˜ | à
outro dispositivo de rede, o que obriga intervençao f ˜ | ísica em caso de remoçao, inserç ˜ | ao ou troca ˜
de modulos SFP. Com a soluç ´ | ao proposta, o SFP ser ˜ | a ligado em um equipamento intermedi ´ | ario ´
que, por sua vez sera ligado ao ´ | switch (figura 3.2). Assim e poss ´ | ível atrelar mais de 1 SFP
a mesma porta do ` | switch, sendo escolhido qual estara realmente ligado ao ´ | switch atraves do ´

controle de uma cadeia de multiplexaçao. ˜

Figura 3.1: Operaçao normal entre ˜ | switch e SFP.
Figura 3.2: Operaçao com intervenç ˜ | ao do ATE entre ˜ | switch e SFP.

27

Alem de possibilitar a inserç ´ | ao, remoç ˜ | ao e troca de SFPs sem intervenç ˜ | ao f ˜ | ísica, o ATE é
dotado de um modulo de injeç ´ | ao de falhas, o qual pode facilitar o teste de toler ˜ | ancia a falhas. ˆ

A abordagem utilizada pode ser aplicada nao somente nos equipamentos usados neste caso ˜

de estudo, mas sim em qualquer equipamento principal que trabalha em conjunto com um equi-

pamento secundario. Essa generalizaç ´ | aõ e muito poderosa, pois possibilita a aplicaç ´ | ao dos con- ˜

ceitos um uma larga gama de aplicaçoes. ˜

## 3.1 Multiplexaçao de SFPs ˜

Em funcionamento normal, os SFPs sao ligados diretamente ao ˜ | switch, como mostra a figura
3.1. A multiplexaçao dos SFPs ˜ | e feita com uma cadeia de multiplexadores que faz a escolha ´
de qual SFP esta ligado ao ´ | switch (figura 3.3). Os SFPs tem diversos pinos, os quais carregam
diferentes sinais, desde alimentaçao at ˜ | e dados e alerta de erros. Esses pinos passam pelos multi- ´
plexadores que, dependendo da configuraçao feita no ATE, ligaram o ˜ | switch em um dos SFPs ou

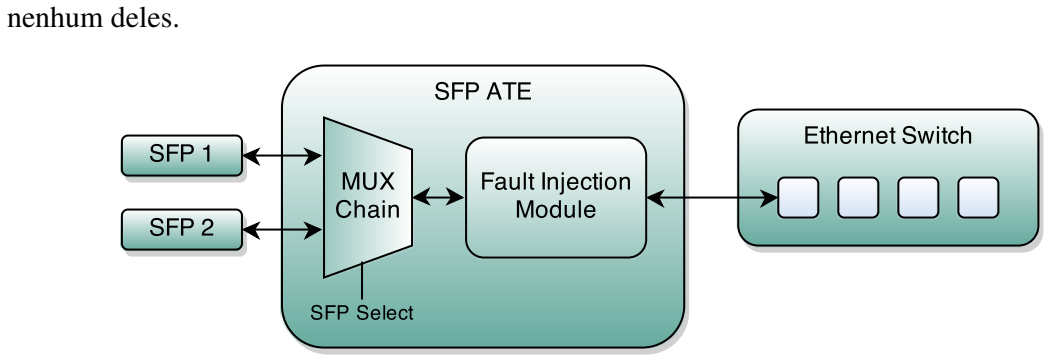
[picture p11: figure]
nenhum deles.

Figura 3.3: Visao geral do ATE. ˜

Com multiplexaçao dos SFPs ˜ | e poss ´ | ível fazer a inserçao e remoç ˜ | ao de SFPs de forma muito ˜

semelhante ao procedimento manual. Desta forma, o processo automatizado e transparente para ´

o equipamento sobre teste, que, por sua vez, produz as mesmas respostas de quando o processo

de inserçao e remoç ˜ | aõ e feito manualmente. ´
Idealmente, a multiplexaçao deveria ocorrer em todos os sinais, por ˜ | em a multiplexaç ´ | ao dos ˜
sinais de TX e RX nao fazem parte do escopo deste estudo. Por serem sinais de alta frequ ˜ | encia ˆ
(na ordem de GHz), os sinais TX e RX exigem roteamento e terminaçoes especiais, o que n ˜ | ao faz ˜

28

parte do objetivo deste estudo. Contudo, com carater experimental, a multiplexaç ´ | ao dos sinais ˜
de TX e RX foi feita. Em testes basicos, o ´ | link foi estabelecido, porem n ´ | ao foi feito testes de ˜
stress de trafego de dados. Com o controle dos sinais de TX e RX, ´ | e poss ´ | ível tambem simular ´
a conexao e desconex ˜ | ao dos cabos, a fim de testar protocolos de comunicaç ˜ | ao em situaç ˜ | oes de ˜

falhas de link.

O processo ocorre com o mínimo de intervençao poss ˜ | ível. Pinos do SFP que trazem os
mesmo sinais (em especial pinos de alimentaçao) s ˜ | ao unidos no ˜ | layout da PCB.
3.2 Modulo de Injeç ´ | ao de Falhas ˜

Os SFPs se comunicam atraves de um barramento I ´

2C, o qual da acesso aos dispositivos ´

internos do SFP. Em casos de falha de um dos dispositivos internos, ou ate mesmo problemas ´

na comunicaçao I ˜

2C, o sistema pode entrar em estado de falha. Esse tipo de falha e dif ´ | ícil de
ser testada, pois raramente se dispoe de SFPs defeituosos, al ˜ | em do que n ´ | ao existem maneiras ˜
de configurar o SFP para nao responder ˜ | a comunicaç ` | ao I ˜

2C. Essa dificuldade de teste e a maior ´

motivaçao para a integraç ˜ | ao de um m ˜ | odulo de injeç ´ | ao de falhas ao ATE. ˜
O modulo de injeç ´ | ao de falhas atua na fase seguinte ˜ | a multiplexaç ` | ao dos SFPs (figura 3.3), ˜

na comunicaçao I ˜

2C, podendo injetar falhas em diversas areas, como PHY, DD e informaç ´ | oes ˜
sobre o SFP. A injeçao de falhas ˜ | e implementada parte em ´ | hardware e parte em software. A parte
do hardware e respons ´ | avel pela separaç ´ | ao dos sinais I ˜

2C, enquanto o software faz o tratamento

das informaçoes, implementa as m ˜ | aquinas de estados I ´

2C e a injeçao de falhas propriamente dita. ˜

O ATE funciona como um escravo I²C do ponto de vista do switch e como um mestre I²C

do ponto de vista do SFP, como mostra a figura 3.4. Essa arquitetura permite que o ATE decida

se a informaçao recebida por um dos lados deve ir at ˜ | e o outro, at ´ | e mesmo devolvendo respostas ´

erradas ao requisitante.

## 3.3 Implementaçaõ

Como ja dito, a implementaç ´ | ao do projeto ˜ | e baseada em uma metodologia h ´ | íbrida de harw-

dare e software. O harwdare e composto pelas PCBs, multiplexadores e conectores do projeto, ´

29

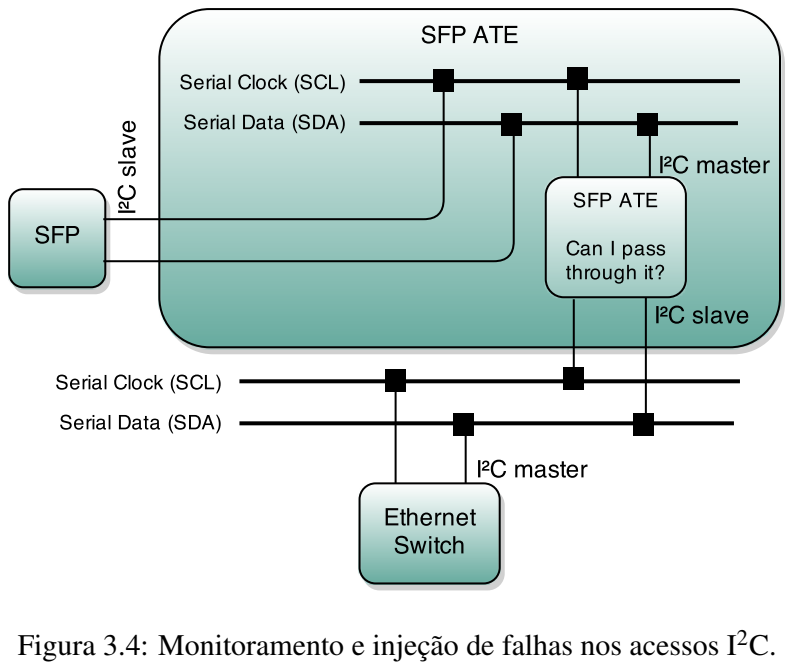
[picture p12: figure]

Figura 3.4: Monitoramento e injeçao de falhas nos acessos I ˜

enquanto o software contem o controle do hardware, implementa a injeçao de falhas e prov ˜ | e a ˆ

interface com o usuario. ´

### 3.3.1 Arquitetura de Hardware

O projeto de hardware visa criar uma infraestrutura física capaz de fazer a multiplexaçao de ˜

todos os sinais do SFPs, alem de disponibilizar os sinais I ´

2Cs para que o processador manipule-

os. A multiplexaçao deve ser o mais transparente poss ˜ | ível para o ethernet siwtch, alvo de testes.
Essa transparencia garante que as caracter ˆ | ísticas do SFP sejam observadas pelo ethernet switch
com a mínima interferencia do equipamento de teste. A figura 3.5 mostra como est ˆ | a dividido o ´
hardware e sera detalhada ainda nesta sub sess ´ | ao. ˜

Dentre os sinais do conector SFP, existem 4 que se destacam. Esses sinais sao os pares ˜

diferenciais TX e RX. Os pares diferenciais TX e RX sao os sinais que carregam os dados ˜ | uteis ´
ao usuario recebidos (RX) e enviados (TX) pelo SFP. A frequ ´ | encia de operaç ˆ | ao desses sinais est ˜ | á

diretamente relacionada com o bit rate do SFP. Por exemplo, se tivermos um SFP de 1Gbps, os

dados que trafegam nos pares diferenciais TX e RX, trafegam em uma frequencia em torno de ˆ

1GHz, o que torna esses sinais extremamente sensíveis.

30

Em virtude disso, o hardware foi dividido em duas PCBs: (1) High Speed PCB (HS-PCB),

que faz a conexao com o ˜ | ethernet switch e a multiplexaçao dos pares diferenciais, e (2) a ˜ | Low
Speed PCB (LS-PCB), que faz a multiplexaçao dos demais sinais e a conex ˜ | ao com o processador. ˜
Essa divisao foi feita a fim de diminuir o tamanho f ˜ | ísico da PCB que fica conectada ao ethernet

switch e, principalmente, isolar os sinais dos pares diferenciais TX e RX a fim de obter a menor

distancia de trilha poss ˆ | ível, reduzindo assim as chances de interferencia e degradaç ˆ | ao dos sinais. ˜
A HS-PCB, alem de fazer a conex ´ | ao com o ˜ | ethernet switch, faz a conexao com os SFPs e envia ˜

os sinais lentos para a LS-PCB, como mostra a figura 3.5.

Alem das PCBs que ser ´ | ao desenvolvidas no presente TCC, ˜ | e utilizado um kit de desenvolvi- ´

mento ARM (ARM-DEV-KIT). Este kit de desenvolvimento possui um microcontrolador ARM,

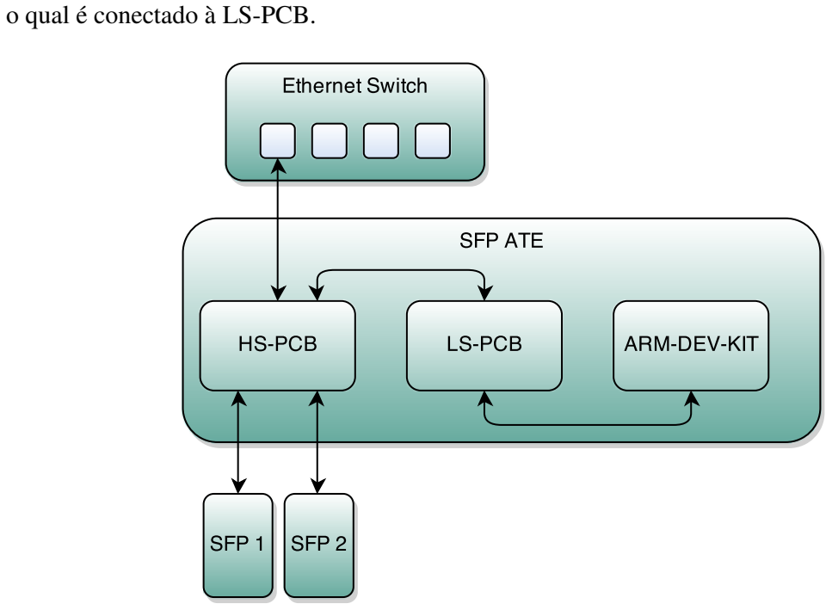
[picture p13: figure]
o qual e conectado ´; a LS-PCB. `

Figura 3.5: Projeto de hardware.

HS-PCB

A HS-PCB (figura 3.6) e basicamente uma PCB conector. Al ´ | em de fazer a conex ´ | ao com ˜

o switch ethernet, com os SFPs e com a LS-PCB, a HS-PCB faz a multiplexaçao dos sinais de ˜

31

dados, os pares diferencias TX e RX.


Figura 3.6: Imagem da HS-PCB.

A multiplexaçao dos pares diferenciais ˜ | e, como todas as outras, controlada pelo ARM-DEV- ´

KIT atraves de dois sinais de controle independentes. Esses sinais de controle passam pela ´

LS-PCB antes de chegar na HS-PCB, porem isso acontece puramente por quest ´ | oes mec ˜ | anicas ˆ

de montagem do ambiente. Para fazer a multiplexaçao dos pares diferenciais foi utilizado o ˜

CI ADG918, da Analog Devices. Segundo o fabricante, este CI implementa um multiplexador

CMOS e trabalha em alta frequencia, na casa de GHz, o que atende as necessidades do sinal ˆ

trafegado nos pinos de TX e RX do SFPs.

LS-PCB

A LS-PCB (figura 3.7) faz a multiplexaçao dos sinais lentos dos SFPs e conex ˜ | ao com o ˜
ARM-DEV-KIT, alem de um rebaixamento de tens ´ | ao que ˜ | e enviado para a HS-PCB para ser ´

usado nos CIs ADG918.

32


Figura 3.7: Imagem da LS-PCB.

A figura 3.8 mostra o layout em blocos da PCB. A multiplexaçao dos SFPs ˜ | e feita atrav ´ | es´
de reles e multiplexadores CMOS CD4053. Os CIs CD4053 fazem a multiplexaç ´ | | | ao dos sinais ˜
de dados, exceto os sinais I²C, que sao conectados em forma de barramento. Apesar das van- ˜

tagens, como tamanho reduzido e simplicidade de montagem dos CD4053s, a multiplexaçao da ˜

alimentaçao dos SFPs foi feita atrav ˜ | es de uma cadeia de rel ´ | es. Segundo o MSA descrito em (SFF ´

COMMITTEE, 2001), a corrente de alimentaçao dos SFPs, pode chegar a 300mA. Com um li- ˜

mite nominal de 15mA por porta, nao foi poss ˜ | ível utilizar o CI CD4053 para a multiplexaçaõ
dos sinais de alimentaçao. Em virtude disso, a opç ˜ | ao de uma cadeia de rel ˜ | es se mostrou atra- ´
tiva devido a facilidade de montagem do circuito e m ` | axima corrente suficientemente grande para ´
a aplicaçao. Al ˜ | em das vantagens iniciais, a cadeia de rel ´ | es proporciona um ru ´ | ído na troca de
posiçao muito semelhante ao ru ˜ | ído da conexao e desconex ˜ | ao manual dos SFPs, devido ˜ | a carac- `

terística de contato seco, ou seja, a troca de posiçao ocorre mecanicamente. ˜

A ligaçao I ˜ | 2C, mostrada na figura 3.9, e feita de forma a isolar os SFPs do ´ | | ethernet switch,

fazendo com que o ATE seja a ligaçao entre os dois. Na LS-PCB existe um barramento I ˜

| | | 2C

que liga uma interface escrava do ARM-DEV-KIT com o switch. Esse barramento recebe as
requisiçoes I ˜ | 2C do switch, que e o mestre I ´

2C do barramento. Os SFPs estao ligados em um outro ˜

barramento onde tambem est ´ a ligado uma interface mestre do ARM-DEV-KIT. Esse barramento ´

33

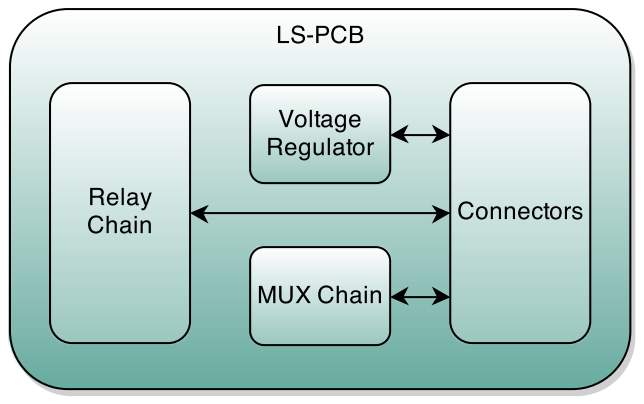
[picture p14: figure]

Figura 3.8: Imagem de blocos da LS-PCB

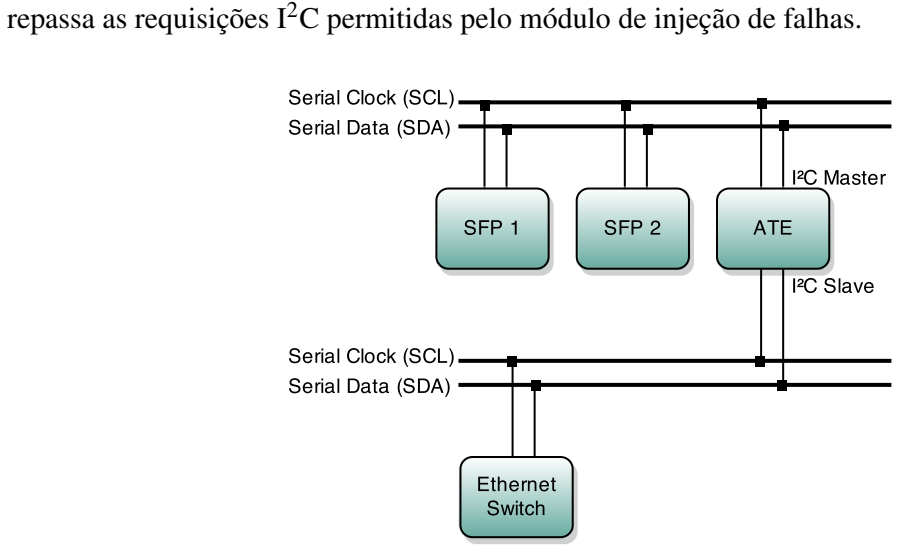
[picture p15: figure]
repassa as requisiçoes I ˜

2C permitidas pelo modulo de injeç ´ | ao de falhas. ˜

Figura 3.9: Ligaçao do I ˜

2C entre ATE, SFP e ethernet switch

Os SFPs normalmente tem os mesmos endereçamentos em seus dispositivos I²C internos.

Para evitar colisao de informaç ˜ | aõ e imprescind ´ | ível que os dois SFPs ligados no ATE nunca
fiquem ligados simultaneamente, ou seja, sempre que a alimentaçao de um dos SFPs ˜ | e ligada, a ´
alimentaçao do outro necessariamente deve estar desligada. Todavia, o ˜ | software de controle faz

testes de coerencia para evitar esse tipo de problema. ˆ

O circuito rebaixador de tensao usa o CI LM317 em conjunto com um esquema de filtragem ˜

tensao proposto no ˜ | datasheet do CI. Como citado anteriormente, ainda nesta sessao, a tens ˜ | aõ

34

rebaixada e utilizada nos multiplexadores GHz localizados na HS-PCB. A tens ´ | aõ e rebaixada de ´

5V para 2,75V, para ficar dentro da faixa de tensao admitida pelo CI. ˜

### 3.3.2 Arquitetura de Sofware

O controle da multiplexaçao dos sinais dos SFPs e a injeç ˜ | ao de falhas da comunicaç ˜ | ao I ˜

2C

e feita atrav ´ | es de um microcontrolador ARM. O ´ | software desenvolvido para o ATE esta embar- ´
cado neste controlador, sem fazer qualquer alteraçao no ˜ | software do sistema alvo de teste. Essa
abordagem elimina qualquer perturbaçao decorrente de mutaç ˜ | ao do programa alvo do teste, uma ˜

vez que este naõ e, de forma alguma, alterado. ´

O software contem o programa que controla todo o projeto. Programa este, escrito na lin- ´

guagem C.

A arquitetura do software (figura 3.10) foi modularizada a fim de facilitar o desenvolvimento

e manutençao do c ˜ | odigo. Existem basicamente quatro grandes m ´ | odulos dividido em tr ´ | es camadas ˆ
de abstraçao. A modularizaç ˜ | ao em camadas de abstraç ˜ | ao bem definidas permite que o projeto ˜
seja modificado com o mínimo de intrusao poss ˜ | ível. Por exemplo, caso o processador fosse
trocado, apenas a camada de abstraçao de ˜ | hardware necessitaria ser alterada, ou se a interface
com o usuario necessitasse de um novo modelo, as camadas mais baixas n ´ | ao seriam afetadas. ˜
Inicialmente, a camada de interface faz a interface com o usuario. ´ | E respons ´ | avel pelo trata- ´

mento das entradas e saídas do programa, para o alto nível.

A camada de configuraçao faz a an ˜ | alise dos dados inseridos pelo o usu ´ | ario, coer ´ | encias, salva ˆ

as configuraçoes e se comunica com a camada inferior para pedir acesso ao processador. ˜

Por fim, a camada de acesso ao hardware possui toda a traduçao de comandos dependente de ˜

processador. Essa camada e respons ´ | avel por atender as requisiç ´ | oes da camada de configuraç ˜ | ao e ˜
tratar interrupçoes de oriundas do ˜ | hardware.
Existe um modulo intermedi ´ | ario, localizado na camada de configuraç ´ | ao, chamado de m ˜ | odulo ´
de Debug. O modulo de ´ | Debug nao necessariamente necessita estar presente na imagem a ser ˜
carregada no processador. Isso ocorre pois a camada de Debug e utilizada para fazer verificaç ´ | oes ˜

e testes durante o desenvolvimento. Essa camada dá a quem a usa a possibilidade de ler e escrever `

em qualquer registrador do processador, alem de fazer leituras e escritas no barramento I ´

2C.

35

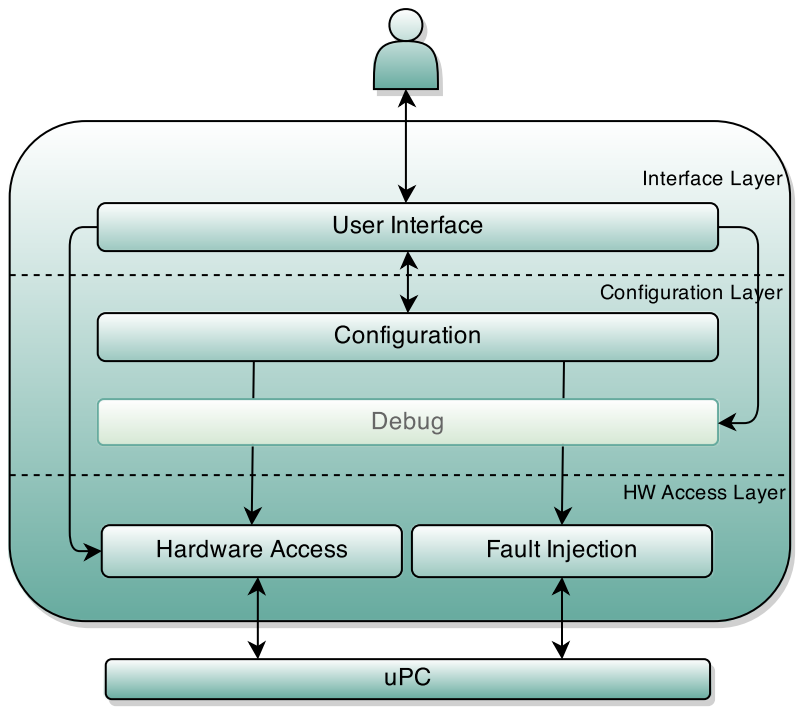
[picture p16: figure]

Figura 3.10: Arquitetura do software

Modulo de Interface com o Usu ´ | ario ´
Este modulo, localizado na camada de Interface, prov ´ | e uma interface com usu ˆ | ario atrav ´ | es´
de um terminal por linha de comando. E poss ´ | ível inserir comandos de açao e comandos de ˜

visualizaçao do estado atual. ˜

E atrav ´ | es deste m ´ | odulo que se d ´ | a toda a comunicaç ´ | ao do ATE desenvolvido neste trabalho ˜
com o mundo exterior. Atraves dele ´ | e feita a configuraç ´ | ao de injeç ˜ | ao de falhas e multiplexaç ˜ | aõ

dos SFPs.

O modulo possui entradas e sa ´ | ídas padroes, o que torna poss ˜ | ível a execuçao atrav ˜ | es de ´ | scripts

de teste e, consequentemente, a automatizaçao de testes. ˜

Alem da ´ | obvia comunicaç ´ | ao com o usu ˜ | ario, este m ´ | odulo tamb ´ | em se comunica com os ´
modulos de configuraç ´ | ao, m ˜ | odulo de acesso ao ´ | hardware e modulo de ´ | debug. A comunicaçaõ
com o modulo de configuraç ´ | aõ e destinada a alterar o estado da configuraç ´ | ao e buscar informaç ˜ | oes ˜
sobre a configuraçao atual. A comunicaç ˜ | ao com o m ˜ | odulo de acesso ao ´ | hardware se da simples- ´

36

mente para que o hardware faça a implementaçao da comunicaç ˜ | ao serial, que ˜ | e utilizada para ´

entra e saída de informaçoes. ˜

Modulo de Configuraç ´ | aõ
Para fazer a configuraçao do ATE existe um m ˜ | odulo de configuraç ´ | ao. Este m ˜ | odulo, ao ´
ser inicializado, parte de uma configuraçao padr ˜ | ao, onde os dois SFPs est ˜ | ao desconectados e ˜
a injeçao de falhas est ˜ | a desabilitada. A partir da inicializaç ´ | ao, ˜ | e poss ´ | ível alterar o estado da
configuraçao atrav ˜ | es da entrada de comandos pela interface com o usu ´ | ario. ´
O modulo de configuraç ´ | ao, al ˜ | em de salvar as configuraç ´ | oes (em mem ˜ | oria vol ´ | atil), imple- ´
menta funçoes que faz toda a verificaç ˜ | ao da configuraç ˜ | ao a ser aplicada, a fim de barrar in- ˜
consistencias, como inserç ˆ | ao simult ˜ | anea de dois SFPs. Tamb ˆ | em´ | e dever deste m ´ | odulo solicitar a ´
alteraçao do n ˜ | ível logico dos pinos de controle dos multiplexadores, rel ´ | es e LEDs de informaç ´ | ao. ˜
Alem de ser ligado com a interface com o usu ´ | ario, o m ´ | odulo de configuraç ´ | aõ e, quando ativo, ´
ligado ao modulo de ´ | debug, explicado anteriormente. Alem disso, este m ´ | odulo faz ligaç ´ | ao com ˜
outros dois modulos: m ´ | odulo de acesso ao ´ | hardware e modulo de injeç ´ | ao de falhas. O acesso ˜
ao hardware faz a traduçao de atribuiç ˜ | ao dos pinos para os respectivos endereços, enquanto o ˜
modulo de injeç ´ | ao de falhas ˜ | e apenas avisado das configuraç ´ | oes das falhas a serem executadas. ˜

Modulo de Acesso ao Hardware ´

Este modulo ´ | e muito simples. Ele basicamente faz a traduç ´ | ao das requisiç ˜ | oes de atribuiç ˜ | aõ
feitas pelo modulo de configuraç ´ | ao para o endereço de mem ˜ | oria relacionado ao registrador pre- ´
tendido, alem da implementaç ´ | ao de terminal serial e m ˜ | aquina de estados I ´

2C.

Apesar de simples, esse modulo ´ | e de extrema import ´ | ancia da manutenibilidade do projeto. ˆ | É
ele que faz a abstraçao do processador para o resto da aplicaç ˜ | ao. Sem ele as atribuiç ˜ | oes e leituras ˜

de registradores estariam espalhadas por todo o codigo, o que tornaria extremamente custosa ´

uma refatoraçao de c ˜ odigo motivada por uma troca de processador. ´

37

Modulo de Injeç ´ | ao de Falhas ˜
O ATE proposto implementa um modulo de injeç ´ | ao de falhas que trabalha na comunicaç ˜ | aõ

I

2C entre o SFP e o ethernet switch. O modulo de injeç ´ | ao de falhas implementa em ˜ | software

uma maquina de estados I ´

2C com falhas controladas. Este controle e enviado pelo m ´ | odulo de ´

configuraçao. ˜

A maquina de estados I ´

2C de injeçao de falhas faz diversas verificaç ˜ | oes onde testam a ˜
habilitaçao da injeç ˜ | ao de algumas falhas propostas neste estudo. Quando uma ou mais falhas ˜
sao habilitadas, a m ˜ | aquina de estados se comporta de forma n ´ | ao padr ˜ | ao, ou n ˜ | ao esperada pela ˜
interface I²C mestre, o que gera a falha.
As falhas escolhidas sao falhas na comunicaç ˜ | ao I ˜

2C. O projeto implementa as seguintes

falhas:

- Falha na leitura e/ou escrita geral de um dispositivo (controlado por endereço de disposi-

tivo);

- Falha na leitura e/ou escrita registrador específico;
- Retorno errado (pre estabelecido) na leitura de um registrador espec ´ | ífico.

As falhas podem ser injetadas de forma geral em um endereço de dispositivo I²C ou em um

registrador específico de um endereço específico de dispositivo I²C. Essa granularidade permite

a injeçao de vetores de falhas mais precisos, testando diversos aspectos da comunicaç ˜ | ao I ˜

2C.

Com o controle da comunicaçao I ˜

2C e poss ´ | ível a injeçao n ˜ | ao somente das falhas implemen- ˜

tadas nesse estudo. Falhas mais específicas podem sem implementadas, como um maior atraso

no tempo de resposta a uma requisiçao, ou falhas espor ˜ | adicas. Uma vez que se tem o controle ´

da maquina I ´

2C, as falhas passíveis de injeçao, dado este projeto como base, s ˜ | ao in ˜ | umeras e ´
implementaveis com facilidade, devido ´ | a modularizaç ` | ao da arquitetura de ˜ | software.

38

4 | Validaçao e Avaliaç ˜ | aõ
As verificaçoes e validaç ˜ | oes foram feitas continuamente durante o processo de desenvolvi- ˜

mento do projeto. Essa abordagem evita a propagaçao de erros e diminui o custo associado ao ˜

re-trabalho em casos de defeitos encontrados.

As verificaçoes feitas podem ser divididas em tr ˜ | es etapas b ˆ | asicas: (1) teste de montagem, (2) ´

teste funcional e (3) teste de integraçao. ˜

Teste de Montagem

Nessa etapa a PCB e testada a fim de validar a montagem da placa, buscando defeitos de ´

curtos e circuitos abertos decorrente de possíveis danos a placa inseridos no processo de `

montagem.

Teste de Funcional

O teste funcional destina-se a validar o esquematico da placa de circuito impresso. Nesse ´

teste a PCB e submetida a est ´ | ímulos a fim de garantir que a PCB esta de comportando de ´

maneira esperada aos estímulos injetados.

Teste de Integraçaõ

Por fim, o sistema une as duas PCBs e o ARM-DEV-KIT, rodando o software desenvolvido

para o ATE, e sao feitos testes a fim de validar funcionalmente o sistema como um todo, ˜

analisando suas funcionalidades finais.

39

## 4.1 Teste das PCBs

Durante este estudo, as PCBs desenvolvidas foram testadas a fim de garantir se correto fun-

cionamento.

### 4.1.1 Teste de Montagem

Durante o processo de teste de montagem, apenas a LS-PCB teve problemas. Enquanto a

HS-PCB foi prototipada utilizando um processo de melhor acabamento, o processo utilizado na

LS-PCB foi um processo mais simples. Ao contrario da HS-PCB, a LS-PCB n ´ | ao possui verniz, ˜

o que torna o processo de soldagem mais perigoso. Alem disso, os furos de passagem, que ligam ´

uma camada com a outra, foram feitos manualmente. Devido a esse problemas, alguns curtos e

circuitos abertos foram inseridos no processo de montagem, porem ap ´ os o teste de montagem ter ´

falhado, foi feito uma revisao na placa e os problemas foram encontrados e corrigidos. ˜

### 4.1.2 Teste Funcional

O teste funcional foi executado separadamente em cada PCB e nos dois casos foi obtido

sucesso. As duas PCBs responderam da forma esperada aos estímulos inseridos.

Foi identificado, na LS-PCB, uma melhoria que poderia ser feita. Os sinais I²C proveni-

entes dos SFPs eram multiplexados da mesma forma que os outros sinais. Com uma analise ´
foi identificado que, como o I²C e uma arquitetura em barramento, ao inv ´ | es da multiplexaç ´ | aõ

os SFPs poderiam ser ligados simultaneamente no mesmo barramento, desde os dois SFPs naõ

ficassem ligado simultaneamente. Essa alteraçao ajuda a diminuir a complexidade do layout da ˜

PCB, porem´ | e apenas um melhoramento. Com o intuito de reduzir a complexidade da PCB, foi ´
gerada uma nova revisao de placa contendo essa alteraç ˜ | ao e outras, detalhadas na sess ˜ | ao 4.2. ˜

## 4.2 Teste de Integraçaõ

Apos a validaç ´ | ao das PCBs separadamente, deve-se fazer um teste de integraç ˜ | ao, unindo ˜

hardware e software, testando o projeto como um todo.

40

### 4.2.1 Multiplexaçaõ

Nos testes de multiplexaçao dos SFPs foi observado que, em casos de SFPs ˜ | opticos, quando o ´

laser era ativado, o consumo de corrente era maior que a corrente maxima suportada pela porta do ´

multiplexador, o que causava desligamento do SFP. Em virtude disso o sistema de multiplexaçaõ

dos sinais de alimentaçao dos SFPs foi reestruturado a fim de contornar o problema da corrente. ˜

Como soluçao a multiplexaç ˜ | ao da alimentaç ˜ | ao dos SFPs foi migrada para uma cadeia de rel ˜ | es. ´
Apos novos testes com a soluç ´ | ao de contorno foi identificado que o problema foi resol- ˜

vido. Em virtude disso, foi gerada uma nova revisao de placa contendo o novo sistema de ˜

multiplexaçao. ˜

Alem do novo sistema de multiplexaç ´ | ao, a nova revis ˜ | ao da LS-PCB conta com um rebaixador ˜
de tensao, que mostrou necess ˜ | ario para a ligaç ´ | ao dos multiplexadores utilizados na HS-PCB, ˜
alem da modificaç ´ | ao citada na sess ˜ | ao 4.1. ˜

### 4.2.2 Injeçao de Falhas ˜

O modulo de injeç ´ | ao de falhas foi a ˜ | ultima etapa a ser desenvolvida. Depois de todo ´ | hard-
ware validado e todo o modulo de multiplexaç ´ | ao funcionando perfeitamente, iniciou-se o desen- ˜

volvimento do software e controle de injeçao de falhas. ˜

Esta etapa foi desenvolvida em constante processo de teste. Apos cada pequena etapa do ´

desenvolvimento o modulo era testado e, quando necess ´ | ario, ajustes eram feitos. ´

Varios problemas foram encontrados inicialmente. Problemas estes relacionados com atraso ´
de resposta da interface I²C, a qual inicialmente nao conseguia fazer comunicaç ˜ | ao com o ˜ | switch.

Depois do problema de comunicaçao ter sido resolvido, pequenos problemas foram encontrados ˜

e corrigidos.

Apos testes finais, o m ´ | odulo de injeç ´ | ao de falhas mostrou-se est ˜ | avel e funcional. ´

41

## 4.3 Analise dos Resultados ´

O projeto de um ATE para equipamentos dotados de SFPs foi testado e validado em um

switch ethernet fornecido pela empresa Datacom.

Neste equipamento foram inseridos diversos modelos de SFPs e testados os modulos de ´

multiplexaçao e injeç ˜ | ao de falhas. O projeto, que ao final teve todas suas funcionalidades vali- ˜

dadas, mostrou-se uma boa alternativa para os testes de SFPs.

Os resultados finais dos testes revelaram este um sistema estavel, com facilidade para a ´

ampliaçao de suas funcionalidades, e que faz o que se prop ˜ | oe: implementa um equipamento que ˜
possibilita a automatizaçao de testes de SFPs, provendo injeç ˜ | ao de falhas na comunicaç ˜ | ao I ˜

2C

com o SFP em teste.

Apesar de nao estar no escopo inicial do trabalho, foi feito tamb ˜ | | | em, de forma experimental, ´

a multiplexaçao dos sinais de TX e RX. O escopo deste trabalho era um ATE que testasse a ˜

configuraçao, por ˜ | em com a multiplexaç ´ | ao dos sinais de TX e RX ˜ | e poss ´ | ível fazer o link entre

duas porta. Essa funcionalidade, por nao estar no escopo, foi testada superficialmente. Nos testes ˜

foi possível observar link up entre duas portas, utilizando o ATE, inclusive trafego de dados. ´

42

# 5 Consideraçoes Finais ˜

A complexidade de alguns equipamentos e sistemas impoe um alto n ˜ | ível de dificuldade du-
rante o processo de verificaçao e validaç ˜ | ao. A automatizaç ˜ | ao de testes pode ajudar muito em ˜
termos de determinismo, tempo de execuçao e confiabilidade do teste, por ˜ | em ela pode encontrar, ´
em alguns casos, entraves quanto a implementaç ` | ao da automatizaç ˜ | ao. ˜
Este estudo revela uma alternativa para a automatizaçao de testes de ˜ | ethernet switches que
usam SFPs. A automatizaçao desses testes traz mais confiabilidade ˜ | | a estes, hoje feitos manual- `

mente, alem de dar mais agilidade e velocidade. ´

Apesar de o projeto usar um cenario espec ´ | ífico como estudo de caso, os conceitos e tecnicas ´
utilizados, como multiplexaçao independente de sinais, e ATEs h ˜ | | íbridos (baseados em hardware

e software), podem ser aplicados em diversas areas onde um equipamento principal trabalha em ´

conjunto com equipamento secundario, ou perif ´ | erico. Essa generalizaç ´ | ao torna o projeto uma ˜

arma poderosa no teste funcional e validaçao de novos equipamentos. ˜

43

Referencias Bibliogr ˆ | aficas ´

BUSHNELL, M. L.; AGRAWAL, V. D. Essentials of Electronic Testing. [S.l.]: Kluwer, 2000.

CISCO SYSTEMS. SGMII Specification. Rev 1.8. [S.l.], 2005. ftp://ftp-eng.cisco.com/ smii/sgmii.pdf.

DELAMARO, M. E.; MALDONADO, J. C.; JINO, M. Introduçao ao Teste de Software ˜ | . [S.l.]:
Elsevier, 2007.

HSUEH, M.-C.; TSAI, T. K.; IYER, R. K. Fault injection techniques and tools. Abril 1997.

I2C-BUS.ORG. I2C Bus. 11 2013. Website. http://www.i2c-bus.org.

PHY. 9 2013. Website. http://pt.wikipedia.org/wiki/PHY.

SFF COMMITTEE. INF-8074i. Rev 1.0. [S.l.], 2001. ftp://ftp.seagate.com/sff/ INF-8074.PDF.

SFF COMMITTEE. SFF-8472. Rev 11.3. [S.l.], 2013. ftp://ftp.seagate.com/sff/ SFF-8472.PDF.

WANG, L.-T.; WU, C.-W.; WEN, X. VLSI Test Principles and Architectures. [S.l.]: Elsevier, 2006.
