redivo/tcc/doc/project/pre-projeto/pre-projeto.pdf

### George Redivo Pinto

# Equipamento para teste de transceptores ethernet

Porto Alegre, Rio Grande do Sul, Brasil

Setembro de 2013

### George Redivo Pinto

# Equipamento para teste de transceptores ethernet

Proposta para Trabalho de Conclusaõ

Orientador:

### Prof. Marcos Augusto Stemmer

PONTIFÍCIA UNIVERSIDADE CATOLICA DO ´ | RIO GRANDE DO SUL

Porto Alegre, Rio Grande do Sul, Brasil

Setembro de 2013

# Resumo

Durante o desenvolvimento de um sistema, varias etapas de teste s ´ | ao executadas a fim de ˜
garantir o correto funcionamento do mesmo. Em equipamentos destinados a aplicaçoes cr ˜ | íticas,
esses testes sao massivos, na tentativa de garantir que o equipamento, em hip ˜ | otese alguma, fuja ´
do comportamento especificado e esperado, quando em campo.

Equipamentos ethernet switch, alem de interagir com outros equipamentos de rede, como ´ hosts, roteadores e outros switches, podem possuir portas do tipo Small Form-factor Pluggable transceiver (SFP) e interagirem diretamente com eles. Idealmente, o processo de teste de equi-
pamentos com portas SFP deve incluir testes de inserçao e remoç ˜ | ao, o que, por sua vez, necessita ˜
de intervençao f ˜ | ísica. Essa intervençaõ e geralmente manual, o que acaba provocando um alto ´
índice de erros.
Nesse contexto, este Trabalho de Conclusao de Curso prop ˜ | oe uma plataforma capaz de vi- ˜
abilizar a automatizaçao dos testes de SFP. Essa plataforma inclui um m ˜ | odulo de simulaç ´ | ao de ˜
falhas. Em mais detalhes, a plataforma sera capaz de fazer a inserç ´ | ao e remoç ˜ | ao de dois SFPs ˜
diferentes em uma mesma porta do ethernet switch, alem da simulaç ´ | ao de falhas no barramento ˜
I
2C, tudo controlado por comunicaçao serial, o que, por sua vez, possibilita a automatizaç ˜ | | ao do ˜
processo como um todo.
Finalmente, a soluçao proposta ser ˜ | a validada em um equipamento de rede fornecido pela ´
empresa Datacom. Neste sentido, sera realizado uma s ´ | erie de experimentos visando a validaç ´ | aõ
da soluçao proposta. ˜

# Abstract

During a product design, several steps are performed to guarantee the correct product operation. In equipment designed for critical applications, these tests are massively stressed, trying to guarantee that the equipment works according to specifications.

Ethernet switches, also may interact with other network equipment, like hosts, routers and another switches, could have Small Form-factor Pluggable transceiver (SFP) ports and may interact directly with these equipment. Ideally the test process on SFP ports must include SFP insertion and removing tests, which requires a physical intervention. This intervention, in general, is done manually, inserting a high human error probability.

This paper proposes an infrastructure to turn automatic SFP tests feasible, including a failsimulation module. This infrastructure will be capable of I²C bus fault injection and to perform insertion and removal of two SFPs in the same ethernet switch’s port, all of it controlled by a serial communication.

This solution will be validated in a network equipment provided by Datacom. Injection, removal and fault injection tests will be performed with the proposed solution, observing the results in the network equipment.

# Sumario ´

Lista de Tabelas

Lista de Figuras

Lista de Siglas | p. 8
1 Introduçaõ | p. 9
2 Fundamentaçao Te ˜ | orica ´ | p. 12
2.1 Portas Ethernet | | p. 12
2.1.1 | Modelo OSI | | p. 12
2.1.2 | Portas físicas | | p. 13
2.1.3 | Configuraçao | ˜ | p. 14
2.2 SFPs | | p. 15
2.2.1 | Tipos de SFPs | | p. 16
2.2.2 | PHY | | p. 17
2.2.3 | Memoria Interna | ´ | p. 18
2.3 Tipos de Teste | | p. 19
2.4 Mecanismos de Injeçao de Falhas | ˜ | p. 20
3 Soluçao Proposta ˜ | p. 22

3.1 Multiplexaçao de SFPs | ˜ | p. 23
3.2 Modulo de Injeç ´ | ao de Falhas | ˜ | p. 23
3.3 Implementaçao | ˜ | p. 24
3.3.1 | Hardware | | p. 24
3.3.2 | Sofware | | p. 25
4 Validaçao e Avaliaç ˜ | aõ | p. 27
5 Cronograma de Atividades | p. 28
6 Consideraçoes Finais ˜ | p. 30
Referencias Bibliogr ˆ | aficas ´ | p. 31

# Lista de Tabelas

2.1 Parametros de configuraç ˆ | ao de portas ˜ | ethernet | | p. 14
5.1 Cronograma de atividades | | p. 28

# Lista de Figuras

2.1 Comunicaçaõ pass-through entre switch e SFP | | p. 16
2.2 Comunicaçao atrav ˜ | es de um PHY combo | ´ | | p. 17
2.3 Comunicaçao atrav ˜ | es de um PHY interno ao SFP el ´ | etrico | ´ | p. 18
3.1 Operaçao normal entre ˜ | switch e SFP | | p. 22
3.2 Operaçao com intervenç ˜ | ao do ATE entre ˜ | switch e SFP | | p. 22

3.3 Monitoramento e injeçao de falhas nos acessos I ˜

| | 2C | | p. 24
3.4 Projeto de hardware | | p. 26

8

# Lista de Siglas

TCC Trabalho de Conclusao de Curso ˜

SFP Small Form-factor Pluggable

XFP 10 Gigabit Small Form-factor Pluggable

ATE Automatic Test Equipment, equipamento de teste automatico ´

MDIX Medium Dependent Interface crossover, interface cruzada dependente de mídia

MSA Multi-Source Agreement, acordo multi-fonte

OSI Open Systems Interconnection, sistema aberto de interconexoes ˜

CI Circuito Integrado

DD Digital Diagnostics, diagnosticos digitais

PCB Printed Circuit Board, placa de circuito impresso

HS-PCB High Speed PCB, PCB de alta velocidade

LS-PCB Low Speed PCB, PCB de baixa velocidade

9

# 1 Introduçaõ

Com o aumento da complexidade dos sistemas atuais, a tarefa de teste e algo de extrema ´

importancia. Um teste, em linhas gerais, ˆ | e uma atividade na qual uma ou mais entradas s ´ | aõ
injetadas em um dado sistema e suas saídas sao analisadas, a fim de encontrar discrep ˜ | ancias ˆ

entre o comportamento especificado e o comportamento real do sistema.

Dependendo das características e dimensoes de um sistema, a tarefa de desenvolvimento ˜

pode se tornar bastante complexa (DELAMARO; MALDONADO; JINO, 2007), o que torna a

atividade de teste de um projeto algo crucial para garantir o bom funcionamento de um produto.

O teste de um projeto pode ser dividido em varias etapas. Entre elas est ´ | ao: (1) teste funcio- ˜
nal, onde o projeto e testado a fim de garantir a conformidade com sua especificaç ´ | | ao comporta- ˜

mental; (2) teste comportamental, onde o alvo do teste e excitado de forma a simular o uso real ´

do equipamento ou sistema, tentando encontrar falhas, para que elas sejam corrigidas antes do

projeto ser dado como pronto. Os estímulos do teste podem ser introduzidos manualmente, com

uma pessoa interagindo ativamente com o alvo do teste. Outra forma, e utilizando componentes ´

automatizadores de teste, onde um elemento pre programado interage com o alvo do teste, inse- ´

rindo os estímulos. Esses componentes sao chamados equipamento de teste autom ˜ | | atico, ATE, do ´

inglesˆ Automatic Test Equipment.

Existem tambem testes envolvendo injeç ´ | ao de falhas, no qual o equipamento ou sistema ˜ | é
testado em condiçoes anormais. Os testes com injeç ˜ | ao de falhas s ˜ | ao utilizados para observar o ˜
comportamento do alvo do teste em uma situaçao de falha tanto do pr ˜ | oprio projeto, quanto de ´

outros subsistemas envolvidos. Com os dados obtidos nos testes com injeçao de falhas pode-se ˜

medir, por exemplo, a robustez do projeto e se ele responde da forma esperada, quando encontra

um estado de falha. As falhas podem ser introduzidas em diversos níveis, desde níveis mais

10

baixos, como curto circuitos, ate o n ´ | ível de usuario, como inserç ´ | ao de um valor inv ˜ | alido em ´
um campo de entrada. Esse tipo de teste e muito ´ | util em aplicaç ´ | oes cr ˜ | íticas, pois essas tem de
se manter sempre ativas e “conscientes” dos problemas. Aplicaçoes cr ˜ | íticas sao, por exemplo, ˜
sistemas de navegaçao de aeronaves, ou sistemas automatizados de controle de metr ˜ | o, os quais ˆ

nunca podem parar, pois causariam um prejuízo muito grande.

Os testes podem ser manuais ou automaticos, dependendo dos requerimentos do teste. Testes ´

manuais tem diversas desvantagens quando comparados com testes automaticos, como menor ´

velocidade de execuçao do teste, tempo gasto com a aprendizagem de um novo procedimento, ˜

falta de consistencia e possibilidade de erro humano na execuç ˆ | ao das tarefas. Embora muitas das ˜

desvantagens sejam relacionadas apenas a requisitos temporais, a possibilidade de erro durante a

execuçao do roteiro de teste est ˜ | a relacionada ´ | a credibilidade do teste. Se, durante a execuç ` | ao de ˜

um teste manual, algum passo do roteiro for pulado, adicionado, ou executado de forma errada,

o teste pode apresentar resultados invalidos, tanto falsos positivos quanto falsos negativos. Por ´

todos esses motivos, o esforço gasto em automatizaçao de testes vem sendo cada vez maior, ˜

assim, os recursos humanos podem ser investidos em outras atividades mais produtivas, como o

aprimoramento dos casos de teste, ao inves de serem gastos na execuç ´ | ao dos mesmos. ˜

Com o objetivo de flexibilizar o uso, alguns equipamentos de rede possuem portas de comunicaçaõ

com conector para a inserçao de um transceptor ( ˜ | transceiver) externo. Um transceiver, do ponto
de vista de redes de dados, e um dispositivo da camada f ´ | ísica, capaz de transmitir e receber da-
dos, fazendo a conversao dos sinais (sinais el ˜ | etricos em ´ | opticos, por exemplo) e/ou a convers ´ | aõ
da interface de comunicaçao. Com diferentes ˜ | transceivers, e poss ´ | ível, por exemplo, uma mesma
porta de comunicaçao ser utilizada com fibra ˜ | optica ou conetor RJ45. ´
A configuraçao aplicada na porta deve ser compat ˜ | ível com o transceptor inserido na mesma,
para evitar comportamentos inesperados. No entanto, devido a possibilidade de variadas configuraç ` | oes ˜
e modelos de transceptores, a configuraçao se torna algo extremamente delicado e suscet ˜ | ível a

erros.

Certos equipamentos sao capazes de configurar automaticamente a porta, baseando-se nas ˜

informaçoes obtidas do transceptor. A dificuldade da autoconfiguraç ˜ | aõ e agravada pelo fato de ´
existir uma grande gama de combinaçoes entre configuraç ˜ | ao e modelo de transceptor. Al ˜ | em´

11

disso, existem casos onde equipamentos sao logicamente empilhados ( ˜ | stacking)

1
. Em um am-

biente de staking, podem existir diversos equipamentos com características diferentes, o que

dificulta a configuraçao destes. ˜

Durante o processo de teste dos trasnceivers, se faz necessario a conex ´ | ao e/ou desconex ˜ | aõ

física dos mesmos, geralmente manual, trazendo os riscos e desvantagens ja citadas anterior- ´

mente. Caso esses procedimentos fossem automatizados, ocorreria um grande acrescimo na ´

produtividade e confiabilidade do teste, porem isso introduziria um elemento a mais no ambiente ´

de testes, um ATE.

Este TCC propoe um soluç ˜ | ao baseada em ˜ | hardware e software que permite a automatizaçaõ

de testes de equipamentos ethernet dotados de transceptores SPFs. Como estudo de caso seraõ

utilizados transceptores SPFs em switches ethernet.

1Do ponto de vista de equipamentos de rede, quando monta-se um ambiente onde varios equipamentos s ´ | aõ
ligados uns aos outros, de forma a se tornarem virtualmente um equipamento so, com capacidade somada e controle ´ centralizado, denomina-se um ambiente stacking.

12

2 | Fundamentaçao Te ˜ | orica ´
Dentro do universo de redes de dados existem inumeras distinç ´ | oes entre tipos de equipamen- ˜
tos, funcionalidades e configuraçoes. O cen ˜ | ario escolhido para o estudo ´ | e o de equipamentos ´

ethernet dotados de portas SFPs.

## 2.1 Portas Ethernet

A ethernet e uma arquitetura de rede de dados largamente utilizada. Ela ´ | | e normatizada pela ´

IEEE 802.3, que descreve todos os detalhes da arquitetura. As portas de um equipamento ether-

net podem ser de tipos variados e ter configuraçoes distintas. Esta sess ˜ | ao destina-se a detalhar as ˜

principais características das portas ethernet.

### 2.1.1 Modelo OSI

O Modelo OSI (Open Systems Interconnection, sistema aberto de interconexoes) ˜ | e uma das ´
mais antigas e mais usadas arquiteturas de comunicaçao entre m ˜ | aquinas. Este modelo divide a ´
comunicaçao em 7 camadas hier ˜ | arquicas. Cada camada tem uma funç ´ | ao bem definida dentro ˜

da comunicaçao e consegue se comunicar apenas com as camadas adjacentes. Essa propriedade ˜

modulariza a comunicaçao de forma a diminuir a complexidade da comunicaç ˜ | | ao como um todo. ˜

As camadas sao divididas da seguinte maneira: ˜

Aplicaçaõ
A camada de aplicaçaõ e a camada de mais alto n ´ | ível. E nela que ficam os ´ | softwares como

navegadores de internet e clientes de e-mail.

13

Apresentaçaõ

Esta camada e respons ´ | avel pela formataç ´ | ao e convers ˜ | ao dos dados. ˜

Sessaõ

A camada de sessao gerencia o fluxo de dados, sendo respons ˜ | avel por tratamento de erros ´

dessa natureza.

Transporte
E respons ´ | avel pela entrega e recebimento dos dados, tentando garantir a confiabilidade de ´

transmissao. ˜

Rede

Esta camada faz o roteamento dos pacotes, escolhendo a melhor rota, baseando-se em

metricas como congestionamento e custo do caminho. ´

Enlace

A camada de enlace e o elo entre a camada f ´ | ísica e a camada de rede. Ela e respons ´ | avel ´

pela configuraçao de fluxo de dados e pela topologia de rede. ˜

Física

Esta e a camada de mais baixo n ´ | ível, onde os sinais logicos e el ´ | etricos s ´ | ao convertidos e ˜

enviados.

Este trabalho atua entre as duas camadas de nível mais baixo: camada física e de enlace.

### 2.1.2 Portas físicas

As portas de um equipamento ethernet servem para fazer a ligaçao entre dois dispositivos em ˜

uma rede ethernet. Diversos conectores ja foram usados em aplicaç ´ | oes ˜ | ethernet e o mais comum
e o conector RJ45, o qual ´ | e usado para fazer a ligaç ´ | ao com um par trançado ˜

1
. Com o desen-
volvimento da tecnologia optica, os cabos de fibra ´ | optica vem se popularizando, principalmente ´
em aplicaçoes de alta frequ ˜ | encia e aplicaç ˆ | oes de longa dist ˜ | ancia. A fibra ˆ | optica, por usar a luz, ´
1Par trançado e um tipo de cabeamento onde dois fios, contendo sinais diferenciais, s ´ | | | | ao enrolados um ao redor ˜
do outro, a fim de diminuir a suscetibilidade a interfer ` | encias eletromagn ˆ | eticas. Cabos ´ | ethernet do padrao CAT 6, ˜
por exemplo, contem 4 pares trançados.

14

pode trabalhar em frequencias muito altas, tem baixo n ˆ | ível de perda de sinal e suscetibilidade
a interferencia. Por outro lado, o cabo el ˆ | etrico, apesar de n ´ | ao possuir tantas vantagens, chega a ˜
1Gbps e distancias de at ˆ | e 100 metros por um custo bem inferior ´ | a fibra ` | optica. ´

Como foi citado no capítulo 1, existem equipamentos com portas as quais seu conector naõ

e nem para fibra ´ | optica, nem para RJ45, mas sim conector para algum ´ | transceiver. Desta forma,

uma mesma porta pode ser usada com cabeamento de fibra optica ou par trançado, dependendo ´

do transceptor conectado. Em aplicaçoes ˜ | ethernet, os transceptores mais comumente usados saõ
os SFPs e XFPs. SFPs sao geralmente usados para aplicaç ˜ | oes de rede ˜ | Gigabit Ethernet, enquanto
XFPs sao usando para aplicaç ˜ | oes de 10 ˜ | Gigabit Ethernet.

### 2.1.3 Configuraçaõ

Cada porta ethernet deve receber uma serie de configuraç ´ | oes para que tenha uma operaç ˜ | aõ
estavel. Essas configuraç ´ | oes ditam desde o ˜ | bit rate, ate configuraç ´ | oes de invers ˜ | ao de TX e RX. ˜
Os parametros mais comuns de configuraç ˆ | ao de uma porta ˜ | ethernet estao listados na tabela 2.1. ˜
Tabela 2.1: Parametros de configuraç ˆ | ao de portas ˜ | ethernet
Parametro ˆ | Descriçaõ
Velocidade | 1 Informa a velocidade do trafego na porta. ´
Duplex | 2 Informa se a conexaõ é Full Duplex ou Half Duplex.
Duplex Capabilities | Informa as configuraçoes de ˜ duplexpossíveis para a porta.¹
Negociaçaõ | Informa se os parametros de MDIX, ˆ duplex e velocidade serao forçados ˜ ou negociados, utilizando as capabilities.
Speed Capabilities | Informa as configuraçoes de velocidade poss ˜ íveis para a porta.¹
MDIX | Informa se a ligaçao de TX e RX est ˜ a normal, invertida ou se ser ´ a con- ´ figurada automaticamente.³
Habilitaçaõ | Informa se a porta esta habilitada ou desabilitada. ´
1Configuraçao v ˜ | alida apenas quando auto negociaç ´ | ao est ˜ | a habilitada. ´
2Configuraçao v ˜ | alida apenas quando auto negociaç ´ | ao est ˜ | a desabilitada. ´
3MDIX auto funciona apenas quando auto negociaçao est ˜ | a habilitada, caso contr ´ | ario o MDIX permanece ´
com o status anterior.
As configuraçoes a serem feitas dependem de diversos fatores como aplicaç ˜ | ao, tipo de cabo, ˜
tipo de conexao e suporte ˜ | as configuraç ` | oes por parte das duas pontas da conex ˜ | ao, da porta e, ˜
em caso de uso de transceivers, suporte as configuraç ` | oes por parte dos ˜ | transceivers. Devido a

15

essa variabilidade, a parte do sistema que executa as configuraçoes ˜ | e extremamente sens ´ | ível. Em
casos onde existe um transceptor na porta, essa sensibilidade e acentuada, pois al ´ | em do suporte ´
de configuraçao das portas dos dois lados da conex ˜ | ao, a configuraç ˜ | ao ainda precisa ser coerente ˜
com o transceptor. Durante o funcionamento do equipamento, e poss ´ | ível trocar o transceiver de

uma porta por outro com características diferentes, o que faz com que configuraçoes diferentes ˜

devam ser escolhidas e aplicadas, dependendo das especificaçoes do transceptor. Exitem ainda ˜

equipamentos com portas chamadas portas combo. Essas portas sao replicadas. Para flexibilizar ˜

as aplicaçoes do equipamento, cada porta combo ˜ | e dotada de um conector SFP e um conector ´
RJ45, porem as duas interfaces n ´ | ao podem ser usadas simultaneamente. Essas portas s ˜ | ao confi- ˜
guradas de maneira completamente diferente em cada mídia (mídia optica, SFP, e m ´ | ídia eletrica, ´
RJ45), o que torna a configuraçao de portas combo mais sens ˜ | | ível a erros.
Com essa dinamica, a configuraç ˆ | ao de portas pode se tornar algo complexo, em especial em ˜
casos onde o equipamento e provido de um m ´ | odulo de auto configuraç ´ | ao. Essas caracter ˜ | ísticas
tornam o teste de configuraçao e troca de transceptores uma tarefa cr ˜ | ítica, pois existem inumeras ´
combinaçoes de configuraç ˜ | ao poss ˜ | íveis, tornando o teste uma tarefa longa e um bom alvo para

ser automatizado.

## 2.2 SFPs

SFP (Small Form-factor Pluggable) e um tipo de transceptor, um modelo de tamanho f ´ | ísico
pequeno, utilizado para conexoes de baixa e m ˜ | edia velocidade (abaixo de 10Gbps). Existem ´
diversos tipos de SFPs. Os SFPs dividem-se basicamente em SFPs eletricos e SFPs ´ | opticos, os ´

quais usam conectores RJ45 e LC, respectivamente.

Os SFPs sao descritos por dois MSA ( ˜ | Multi-Source Agreement), INF-8074 e SFF-8472.
Esses documentos definem como devem ser as características mecanicas, el ˆ | etricas e l ´ | ogicas, ´
como dimensoes, imped ˜ | ancias e endereçamento das informaç ˆ | oes. Como esses documentos n ˜ | aõ

sao uma norma oficial, apenas um acordo entre alguns dos grandes fabricantes desses equipa- ˜

mentos, existe a possibilidade de alguns modelos nao seguirem as recomendaç ˜ | oes. Isso torna ˜
a configuraçao das portas envolvendo SFPs mais dif ˜ | | ícil e perigosa. SFPs que nao seguem as ˜

especificaçoes dos MSAs podem apresentar comportamentos indefinidos. Por esse motivo al- ˜

16

guns fabricantes de equipamentos que usam SFPs tem uma política de homologaçao de SFPs e ˜

bloqueio de SFPs nao homologados. ˜

### 2.2.1 Tipos de SFPs

Entre todos os modelos de SFPs existem dois grandes grupos: os SFPs eletricos e os SFPs ´

opticos. Dentro desses grupos existem outras subdivis ´ | oes. As divis ˜ | oes s ˜ | ao feitas a fim de separar ˜
os SFPs por velocidade, possibilidade de negociaçao, ˜ | capabilities e, especificamente para SFPs
opticos, existem divis ´ | oes de comprimento de onda e dist ˜ | ancia m ˆ | axima (pot ´ | encia) do ˆ | laser.

Os variados tipos de SFPs necessitam de configuraçoes diferentes, alguns suportam mais ˜

configuraçoes que outros. Isso faz com que, em caso de auto configuraç ˜ | | | | ao, de alguma forma, ˜
o equipamento que esta hospedando o SFP deva conseguir descobrir informaç ´ | oes pertinentes ˜
as configuraç ` | oes e fazer a correta aplicaç ˜ | ao dessas configuraç ˜ | oes. Essas informaç ˜ | oes est ˜ | ao dis- ˜

postas em um memoria dentro do SFP, acessada por I ´

2C, cujo mapeamento e descrito pelos ´

documentos INF-8074 e SFF-8472 (SFF COMMITTEE, 2001) (SFF COMMITTEE, 2013).

Os SFPs opticos fazem uma passagem direta ( ´ | pass-through) na comunicaçao com o ˜ | switch
(figura 2.1), utilizando o PHY (melhor detalhado em 2.2.2) do proprio ´ | switch para fazer as
configuraçoes, apenas transformando o sinal ˜ | | optico em sinal el ´ | etrico e vice-versa. J ´ | | a os SFPs ´
eletricos possuem um PHY interno, o qual deve ser configurado com os par ´ | | | | ametros vistos na ˆ
tabela 2.1, alem da configuraç ´ | ao do pr ˜ | oprio ´ | switch.

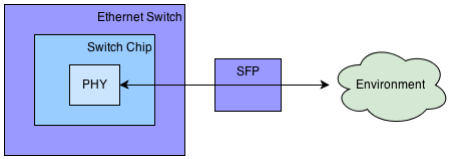
[picture p17: figure]

Figura 2.1: Comunicaçaõ pass-through entre switch e SFP.

17

### 2.2.2 PHY

PHY, do inglesˆ physical, do ponto de vista de redes ethernet, e um dispositivo que trabalha ´

na camada física do modelo OSI, capaz de fazer a conversao de sinais anal ˜ | ogicos em digitais, e ´
vice-versa, enviando e recebendo frames ethernet (PHY, 2013). Alem das configuraç ´ | oes citadas ˜
na tabela 2.1, alguns PHYs dispoes de algumas configuraç ˜ | oes e informaç ˜ | oes mais espec ˜ | íficas,
como tipo de mídia, protocolo de comunicaçao e invers ˜ | ao de trilhas. ˜

Esses dispositivos podem ser um circuito integrado (CI) separado, ou estar integrado em um

CI com mais funcionalidades. O trafego de uma porta ´ | ethernet pode passar por mais de um

PHY, mesmo antes de sair do equipamento origem. Isso acontece em casos de portas combo, por

exemplo, onde alem de o tr ´ | afego passar pelo PHY integrado no chip do ´ | switch, pode passar por
mais um PHY, que e respons ´ | avel de escolher qual lado (porta el ´ | etrica ou porta SFP) ser ´ | a enviado ´

ou, em caso de recebimento, qual porta sera escutada, como mostra a figua 2.2. Outro caso onde ´

ha mais de um PHY envolvido, ´ | e em ocasi ´ | oes em que usamos SFPs el ˜ | etricos (figura 2.3), como ´
explicado na sessao 2.2.1, onde esse PHY ˜ | e acessado atrav ´ | es de uma comunicaç ´ | ao I ˜

2C com o

SFP. Nesses casos existe um PHY para fazer a comunicaçao do ˜ | switch ate o SFP e outro PHY, ´
no SFP que faz a comunicaçao at ˜ | e o outro lado da conex ´ | ao. ˜

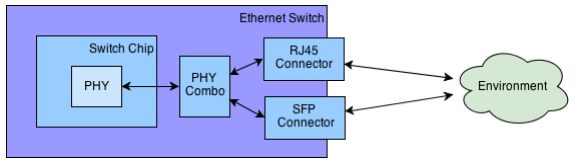
[picture p18: figure]

Figura 2.2: Comunicaçao atrav ˜ | es de um PHY combo. ´

Em todos os casos onde existe mais de um PHY em um mesmo lado da comunicaçaõ é

necessario fazer a correta configuraç ´ | ao de todos os PHYs. Essas configuraç ˜ | oes podem variar ˜

de caso para caso, dependendo de características estaticas, como da arquitetura do equipamento, ´

e características dinamicas, como a topologia de rede e aplicaç ˆ | ao no qual o equipamento em ˜
questao est ˜ | a sendo utilizado. ´

18

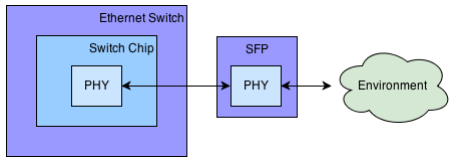
[picture p19: figure]

Figura 2.3: Comunicaçao atrav ˜ | es de um PHY interno ao SFP el ´ | etrico. ´

### 2.2.3 Memoria Interna ´

Os SFPs sao providos de mem ˜ | oria interna. Essa mem ´ | oria guarda informaç ´ | oes sobre o SFP, ˜
como nome do fabricante, codigo do produto e n ´ | umero de s ´ | erie, al ´ | em de dados pertinentes ´ | a auto `
configuraçao, como taxa m ˜ | axima de dados e ´ | Ethernet Standard.
Alguns SFPs sao providos de um sistema chamado ˜ | Digital Diagnostics (DD), especidicado
pela SFF-8472, que e um sistema de monitoramento do status do SFP. O DD guarda informaç ´ | oes ˜
sobre temperatura do SFP, potencia do ˆ | laser (TX e RX) e alarmes. Esses dados sao lidos em ˜
tempo real e salvos na memoria do SFP. Lendo informaç ´ | oes de DD ˜ | e poss ´ | ível ter um relatorio ´
da saude do SFP, o que pode ser usado para executar aç ´ | oes de prevenç ˜ | ao ou simplesmente como ˜

um informativo ao usuario. ´

As informaçoes disponibilizadas na mem ˜ | oria do SFP s ´ | ao a base para decis ˜ | oes de autoconfiguraç ˜ | aõ
dos equipamentos hospedeiros de SFPs. E na mem ´ | oria que est ´ | a toda a informaç ´ | ao acess ˜ | ível. A
disposiçao das informaç ˜ | oes da mem ˜ | oria dos SFPs s ´ | ao descritas pelos MSAs citados no cap ˜ | ítulo
2.2, mas como foi dito anteriormente, como as MSAs nao s ˜ | ao normas, os SFPs podem ou n ˜ | aõ

seguir essas recomendaçoes. ˜

Ainda existem areas de mem ´ | oria espec ´ | íficas para o vendedor do SFP. Essas areas possibi- ´
litam o vendedor gravar informaçoes como nome do vendedor, ˜ | part number específico usado
pelo vendedor e quaisquer outras informaçoes, como c ˜ | odigo de homologaç ´ | ao, ou informaç ˜ | oes ˜
adicionais para a identificaçao do m ˜ | odulo SFP. ´

19

## 2.3 Tipos de Teste

A atividade desenvolvimento de um sistema e uma tarefa complexa e est ´ | a sujeita a uma s ´ | erie ´

de problemas. Esses problemas sao inerentes ao desenvolvimento de um projeto, e eles ocor- ˜

rerao mesmo com a utilizaç ˜ | ao de m ˜ | etodos e ferramentas de engenharia (DELAMARO; MAL- ´

DONADO; JINO, 2007). No desenvolvimento de um produto de alta qualidade, varias etapas de ´

testes sao executadas, a fim de garantir a qualidade do projeto. Quanto mais cr ˜ | ítica e a aplicaç ´ | aõ
do projeto a ser desenvolvido, mais se faz necessario boas t ´ | ecnicas de testes, visando o maior ´

coeficiente de cobertura de falhas.

Ao contrario do que muitos pensam, o objetivo do teste n ´ | | aõ e provar que um sistema n ´ | aõ

possui falhas, mas sim encontrar as falhas que tal sistema possui, antes desse ser dado como

pronto. Quanto mais cedo um problema for detectado, menos custosa sera a correç ´ | ao deste. ˜
Imagine que foi detectado um serio problema arquitetural em um dado CI. Caso este CI j ´ | a tenha ´
sido vendido, dependendo da criticidade de sua tarefa, sera necess ´ | ario trocar as unidades que ´

foram vendidas. Por outro lado, se o problema for descoberto na fase de projeto, o CI passará

por um processo de correçao, sem necessidade de um ˜ | recall.
Com o aumento da complexidade dos sistemas, podem ser necessarios testes em v ´ | arias etapas ´
do desenvolvimento de um produto. Os teste vao desde a etapa de especificaç ˜ | ao, que verifica se ˜
as especificaçoes s ˜ | ao coerentes com o que se espera do projeto, at ˜ | e a n ´ | ível de aplicaçao, onde ˜
sao verificadas funcionalidades a n ˜ | | ível de usuario. ´
Mesmo apos um produto ser criado, produzido e vendido, pode ser necess ´ | ario a avaliaç ´ | aõ
constante das condiçoes do produto. Nesses casos, durante a etapa de projeto, s ˜ | ao previstos ˜
mecanismos de detecçao de falhas, que s ˜ | ao embarcados no sistema. Esses testes podem ser ˜

do modo online ou offline. Os testes online sao executados durante o funcionamento do sistema, ˜

enquanto os offline param a execuçao do sistema, ou s ˜ | ao rodados em momentos em que o sistema ˜
nao est ˜ | a ativo, como na inicializaç ´ | ao ou encerramento de um ciclo de atividades. Um exemplo ˜
classico desse tipo de teste ´ | e o teste de mem ´ | oria, que faze um auto teste durante a inicializaç ´ | aõ

do sistema.

Entre os testes executados antes da venda de um produto, esta o teste funcional, o qual ´

sera abordado neste estudo. O teste funcional tem por objetivo encontrar falhas em requisitos ´

20

funcionais do projeto, verificando inconsistencias entre a especificaç ˆ | ao e a execuç ˜ | ao real de um ˜
sistema. Para que esse tipo de teste seja realizado com a maior eficiencia poss ˆ | ível, e necess ´ | ario ´
conhecer a arquitetura do sistema. Com esse conhecimento e poss ´ | ível gerar casos de teste que

excitem partes sensíveis do projeto, ou seja, casos de teste que possuam a maior probabilidade

de revelar erros possível.

Por vezes, e necess ´ | ario mais do que apenas entradas de usu ´ | ario para que os casos de teste ´
tenham uma cobertura de falhas aceitavel. Dependendo da ´ | area que se quer excitar, ´ | e necess ´ | ario ´
fazer variaçoes de temperatura, incid ˜ | encia de ru ˆ | ídos e ate mesmo injeç ´ | ao artificial de falhas, o ˜
que sera visto no cap ´ | ítulo 2.4.

## 2.4 Mecanismos de Injeçao de Falhas ˜

Equipamentos tolerantes a falhas sao equipamentos capazes de contornar ou se recuperar de ˜

um determinado conjunto de falhas. Esses equipamentos devem conseguir, de alguma forma, de-

tectar falhas e tomar alguma atitude de modo que a falha afete o mínimo possível o equipamento.

Muitas vezes o teste de equipamentos tolerantes a falhas naõ e trivial. Isso se d ´ | a pelo simples ´
fato de que as falhas nao ocorrem frequentemente. Em vista disso, s ˜ | ao desenvolvidos mecanis- ˜

mos de injeçao de falhas, que tem por objetivo injetar artificialmente falhas, a fim de avaliar a efe- ˜

tividade dos mecanismos de tolerancia a falhas de um dado equipamento ou sistema. (HSUEH; ˆ

TSAI; IYER, 1997)

Os testes envolvendo injeçao de falhas podem ser feitos basicamente em dois n ˜ | íveis: injeçaõ
de falhas baseado em simulaçao e baseado em prot ˜ | otipo. Injeç ´ | ao de falhas baseada em simulaç ˜ | oes ˜
e utilizada na etapa de projeto de um sistema, onde o sistema ainda n ´ | ao existe de fato. J ˜ | a a injeç ´ | aõ
de falhas baseada em prototipo ´ | e executada com o sistema real, na sua fase de teste. (HSUEH; ´

TSAI; IYER, 1997)

Os mecanismos de injeçao de falhas podem ser divididos em tr ˜ | es tipos: baseados em ˆ | hard-

ware, baseados em software e híbridos.

Os mecanismos baseados em hardware sao sistemas f ˜ | ísicos adicionais ou alteraçoes do ˜ | hard-

ware do projeto alvo de testes. Eles visam injetar artificialmente um determinado conjunto de

21

falhas. Essas falhas podem ser fenomenos como curtos circuitos, circuitos abertos, flutuaç ˆ | ao de ˜
tensao de alimentaç ˜ | ao, entre outros. ˜
Quando baseada em software, a injeçao de falhas pode ser feita alterando o c ˜ | odigo a n ´ | ível de
compilaçao, com ˜ | #ifdefs, da linguagem C, por exemplo, o que faz com que a injeçao de falhas ˜
seja estatica. Outra forma, ´ | e adotar uma abordagem onde as falhas podem ser controladas em ´
tempo de execuçao. Essa soluç ˜ | ao implica em uma maior intrus ˜ | ao no ˜ | software ”real”, o que pode

introduzir problemas nao existentes no projeto original, podendo causar falsos positivos e/ou ˜

falsos negativos.

A soluçao h ˜ íbrida adota as duas abordagens. hardware e software, em conjunto.

Enquanto mecanismos em hardware podem ter um alto custo de tempo e de recursos finan-

ceiros, devido ao fato de ele necessariamente precisar ser construído, os mecanismos baseados

em software geralmente exigem apenas custo de tempo. Porem, os mecanismos baseados em ´

hardware geralmente tem um risco de distorçao de resultado muito menor que os baseados em ˜

software. Isso ocorre pelo fato de que quando um modulo extra ´ | e introduzido no ´ | software,

o comportamento do sistema como um todo sofre uma perturbaçao ativa, proveniente dessa ˜

modificaçao, que pode alterar sua resposta ˜ | as falhas. `
Alem das quest ´ | oes como custo e perturbaç ˜ | ao no sistema, antes da escolha de qual abordagem ˜
seguir e necess ´ | ario conhecer bem qual o tipo de falhas se deseja injetar. Algumas falhas simples- ´
mente nao podem ser injetadas por uma das abordagens. Por exemplo, uma falha de flutuaç ˜ | | | | ao de ˜
tensao n ˜ | ao pode ser injetada em ˜ | software, assim como valores invalidos em um campo de entrada ´
nao podem ser injetados atrav ˜ | es de ´ | hardware.
Existem tambem ocasi ´ | oes onde o mais adequado ˜ | e a soluç ´ | ao h ˜ | íbrida, usando as duas meto-

dologias para implementar diferentes partes do mecanismo de injeçao de falhas. ˜

22

# 3 Soluçao Proposta ˜

Como soluçao para a dificuldade de automatizaç ˜ | ao de testes com SFPs, este trabalho prop ˜ | oẽ

um ATE, baseado em metodologia híbrida (hardware e softwate), que funcione como um media-

dor entre os SFPs e o equipamento hospedeiro de SFPs, implementando um modulo de injeç ´ | ao de ˜
falhas e um multiplexador de SFPs, que sera detalhado neste cap ´ | ítulo. Em uma ligaçao normal, ˜
o SFP seria ligado diretamente ao switch (figura 3.1), e entao ligado ˜ | a outro dispositivo de rede, `
o que obriga intervençao f ˜ | ísica em caso de remoçao, inserç ˜ | ao ou troca de m ˜ | odulos SFP. Com ´
a soluçao proposta, o SFP ser ˜ | a ligado em um equipamento intermedi ´ | ario que, por sua vez ser ´ | á
ligado ao switch (figura 3.2). Assim e poss ´ | ível atrelar mais de 1 SFP a mesma porta do ` | switch,

sendo escolhido qual estaria realmente ligado ao switch por uma cadeia de multiplexaçao. ˜

Figura 3.1: Operaçao normal entre ˜ | switch e SFP.
Figura 3.2: Operaçao com intervenç ˜ | ao do ATE entre ˜ | switch e SFP.
Alem de possibilitar a inserç ´ | ao, remoç ˜ | ao e troca de SFPs sem intervenç ˜ | ao f ˜ | ísica, o ATE será

23

dotado de um modulo de injeç ´ | ao de falhas, o qual poder ˜ | a facilitar o teste de toler ´ | ancia a falhas. ˆ

A abordagem utilizada pode ser aplicada nao somente nos equipamentos usados neste caso ˜

de estudo, mas sim em qualquer equipamento principal que trabalha em conjunto com outro

equipamento (secundario). Essa generalizaç ´ | aõ e muito poderosa, pois possibilita a aplicaç ´ | ao dos ˜

conceitos um uma larga gama de aplicaçoes. ˜

## 3.1 Multiplexaçao de SFPs ˜

Em funcionamento normal, os SFPs sao ligados diretamente ao ˜ | switch, como mostra a figura
3.1. A multiplexaçao dos SFPs ser ˜ | a feita com uma cadeia de multiplexadores que far ´ | ao a escolha ˜
de qual SFP estara ligado ao ´ | switch (figura 3.2). Os SFPs tem diversos pinos, os quais carregam
diferentes sinais, desde alimentaçao at ˜ | e dados e alerta de erros. Esses pinos passar ´ | ao pelos ˜
multiplexadores que, dependendo da configuraçao feita no ATE, ligar ˜ | ao o ˜ | switch em um dos

SFPs ou nenhum deles.

Idealmente, a multiplexaçao deveria ocorrer em todos os sinais, por ˜ | em n ´ | ao ser ˜ | a feita com os ´

sinais de TX e RX. Por serem sinais de alta frequencia (na ordem de GHz), os sinais TX e RX ˆ

exigem roteamento e terminaçoes especiais. O tratamento desses detalhes fogem do escopo do ˜

estudo. Contudo, a nao multiplexaç ˜ | ao dos sinais de TX e RX n ˜ | ao dever ˜ | a afetar o resultado do ´
estudo, uma vez que a configuraçao do m ˜ | odulo SFP e leitura de configuraç ´ | oes e caracter ˜ | ísticas do
mesmo naõ e afetada, afetando apenas o tr ´ | afego de dados. Como car ´ | ater experimental, ser ´ | a feita ´
uma tentativa de multiplexaçao, sem pretens ˜ | ao de passagem de dados, a fim de tentar estabelecer ˜

o link entre os dois lados da conexao. ˜

O processo ocorrera com o m ´ | ínimo de intervençao poss ˜ | ível. Pinos do SFP que trazem os
mesmo sinais (em especial pinos de alimentaçao) ser ˜ | ao unidos no ˜ | layout da PCB.
3.2 Modulo de Injeç ´ | ao de Falhas ˜

Os SFPs se comunicam atraves de um barramento I ´

2C, o qual da acesso tanto ´ | a mem ` | oria ´
quanto ao PHY, em caso de SFP eletrico. Em casos de falha da mem ´ | oria, PHY ou at ´ | e mesmo da ´

comunicaçao I ˜

2C, o sistema entra em estado de falha. Esse tipo de falha e dif ´ ícil de ser testada,

24

pois raramente temos SFPs defeituosos e nao se tem uma forma de configurar o SFP para n ˜ | aõ
responder a comunicaç ` | ao I ˜
2C. Essa dificuldade de teste e a maior motivaç ´ | ao para a integraç ˜ | ao de ˜
um modulo de injeç ´ | ao de falhas ao ATE. ˜
O modulo de injeç ´ | ao de falhas ir ˜ | a atuar no barramento I ´

2C, podendo simular falhas em

diversas areas, como PHY, DD e informaç ´ | oes sobre o SFP. A injeç ˜ | ao de falhas ser ˜ | a implementada ´
parte em hardware e parte em software. A parte do hardware sera respons ´ | avel pela separaç ´ | ao e ˜

multiplexaçao dos sinais I ˜

2C, enquanto o software fara o tratamento das informaç ´ | oes e a injeç ˜ | aõ

de falhas propriamente dita.

O ATE funcionara como um escravo I ´

2C do ponto de vista do switch e como um mestre I²C

do ponto de vista do SFP, como mostra a figura 3.3. Essa arquitetura permitira que o ATE decida ´

se a informaçao recebida por um dos lados deve ir at ˜ | e o outro, at ´ | e mesmo devolvendo respostas ´

erradas ao requisitante.

Figura 3.3: Monitoramento e injeçao de falhas nos acessos I ˜

2C.

## 3.3 Implementaçaõ

Como ja dito, a implementaç ´ | ao do projeto ser ˜ | a baseada em uma metodologia h ´ | íbrida de

harwdare e software. O harwdare sera composto pelas PCBs e conectores do projeto, enquanto ´

o software contera o controle do ´ | hardware e provera a interface com o usu ´ | ario. ´

### 3.3.1 Hardware

O projeto de hardware visa criar uma infraestrutura física capaz de fazer a multiplexaçao de ˜
todos os sinais do SFPs, alem de disponibilizar os sinais I ´ | | | 2Cs para que o processador manipule-

25

os. A multiplexaçao deve ser o mais transparente poss ˜ | ível para o ethernet siwtch, alvo de testes.
Essa transparencia garantir ˆ | a que as caracter ´ | ísticas do SFP sejam observadas pelo ethernet switch
com a mínima interferencia do equipamento de teste. A figura 3.4 mostra como ser ˆ | | | a dividido o ´
hardware e sera detalhada ainda nesta sub sess ´ | ao. ˜

Dentre os sinais do conector SFP, existem 4 que se destacam. Esses sinais sao os pares dife- ˜

renciais TX e RX. Os pares diferenciais TX e RX sao os sinais que carregam os dados recebidos ˜

e enviados pelo SFP. A frequencia de operaç ˆ | ao desses sinais est ˜ | a diretamente relacionada com o ´

bit rate do SFP. Por exemplo, se tivermos um SFP de 1Gbps, os dados que trafegam nos pares

diferenciais TX e RX, trafegam em uma frequencia de 1GHz, o que torna esses sinais extrema- ˆ

mente sensíveis. Em virtude disso, o hardware sera dividido em duas PCBs: ´ | High Speed PCB
(HS-PCB), que fara a conex ´ | ao com o ˜ | ethernet switch e a multiplexaçao dos pares diferenciais, ˜
e a Low Speed PCB (LS-PCB), que fara a multiplexaç ´ | ao dos demais sinais e a conex ˜ | ao com o ˜
processador. Essa divisao foi feita a fim de diminuir o tamanho f ˜ | | | ísico da PCB que ficara co- ´

nectada ao ethernet switch e, principalmente, isolar os sinais dos pares diferenciais TX e RX a

fim de obter a menor distancia de trilha poss ˆ | ível, reduzindo assim as chances de interferencia e ˆ
degradaçao dos sinais. A HS-PCB, al ˜ | em de fazer a conex ´ | ao com p ˜ | ethernet switch, faz a conexaõ

com os SFPs e envia os sinais lentos para a LS-PCB, como mostra a figura 3.4.

Alem das PCBs que ser ´ | ao desenvolvidas no presente TCC, ser ˜ | a utilizado um kit de desen- ´

volvimento ARM. Este kit de desenvolvimento possui um microcontrolador ARM, o qual será

conectado com a LS-PCB.

### 3.3.2 Sofware

A multiplexaçao dos sinais dos SFPs e a monitoraç ˜ | ao/injeç ˜ | ao de falhas da comunicaç ˜ | ao I ˜ 2C
sera feita atrav ´ | es de um microcontrolador ARM. O ´ | software sera embarcado neste controlador, ´
sem fazer qualquer alteraçao no ˜ | software do sistema alvo de teste. Essa abordagem elimina
qualquer perturbaçao decorrente de mutaç ˜ | ao do programa alvo do teste, uma vez que este n ˜ | | aõ e,´

de forma alguma, alterado.

O software contera o programa que controlar ´ | a todo o projeto. Este programa, escrito na ´

linguagem C.

26


Figura 3.4: Projeto de hardware.

A interface com o usuario ´ | e implementada no ´ | software do ATE, o que possibilita o usuario ´
a fazer configuraçoes, em tempo de execuç ˜ | ao, a fim de escolher qual SFP ser ˜ | a conectado ao ´
ethernet switch e fazer as escolhas relativas ao modulo de injeç ´ | ao de falhas. Al ˜ | em da interface ´
com o usuario, o ´ | software fara o controle l ´ | ogico do ´ | hardware e implementara o m ´ | odulo de injeç ´ | aõ

de falhas.

A interface com o usuario ser ´ | a uma interface de linha de comando via comunicaç ´ | ao serial. ˜
Isso permitira ao usu ´ | ario usar algum ´ | framework de testes que acesse a serial do SFP ATE e

automatizar os testes feitos pelo projeto.

27

4 | Validaçao e Avaliaç ˜ | aõ
Apos conclu ´ | ída a implementaçao deste trabalho, inicia-se a etapa de validaç ˜ | ao e avaliaç ˜ | aõ

dos resultados. Para validar o equipamento, sera usado um equipamento de rede, dotado de ´

portas com conectores SFP em conjunto de dois modelos diferentes de SFPs.

O SFP ATE sera submetido ´ | a diversos testes que executar ` | ao todas as funcionalidades pro- ˜

postas no presente documento. A validaçao tem como objetivo avaliar a capacidade de o SFP ˜

ATE prover condiçoes da automatizaç ˜ | ao de testes de SFPs. ˜

Ao final do desenvolvimento, espera-se que o SFP ATE seja capaz de fazer a multiplexaçaõ

dos SFPs, de maneira que o alvo do teste nao perceba qualquer interfer ˜ | encia do equipamento in- ˆ
troduzido, alem de uma injeç ´ | ao efetiva e control ˜ | avel de falhas no barramento I ´

2C, na comunicaçaõ

entre o SFP e o ethernet switch.

28

# 5 Cronograma de Atividades

O tabela 5.1 apresenta uma previsao de cronograma de atividades. ˜

Tabela 5.1: Cronograma de atividades

Atividade | Agosto | Setembro | Outubro | Novembro
1 | 2 | 3 | 4 | 5 | 1 | 2 | 3 | 4 | 1 | 2 | 3 | 4 | 5 | 1 | 2 | 3 | 4
Definiçao do projeto de TCC ˜
Layout da LS-PCB
Montagem da LS-PCB
Teste da LS-PCB
Layout da HS-PCB
Montagem da HS-PCB
Teste da HS-PCB
Proposta de TCC
Modulo de multiplexaç ´ aõ Modulo de injeç ´ ao de falhas ˜ Testes finais
Painel TCC
Volume final do TCC

Definiçao do projeto de TCC ˜

A definiçao da projeto de TCC consiste no planejamento do estudo a ser desenvolvido. ˜

Layout da LS-PCB

Esta etapa destina-se desenvolver o esquema eletrico e ´ | layout da LS-PCB.

Montagem da LS-PCB

Apos a prototipaç ´ | ao da LS-PCB ˜ | e necess ´ | ario fazer a montagem, solando os componentes. ´

29

Teste da LS-PCB

O teste da placa consiste na injeçao de sinais a fim de avaliar se n ˜ | ao houveram erros no ˜

projeto e/ou montagem da LS-PCB.

Layout da HS-PCB

Idem a descriç ` | ao similar, da LS-PCB. ˜

Montagem da HS-PCB

Idem a descriç ` | ao similar, da LS-PCB. ˜

Teste da HS-PCB

Idem a descriç ` | ao similar, da LS-PCB. ˜

Proposta de TCC

Descriçao detalhada da proposta de projeto para TCC. ˜

Modulo de multiplexaç ´ | aõ
Implementaçao, em ˜ | software, do modulo que controla a multiplexaç ´ | ao dos SFPs. ˜
Modulo de injeç ´ | ao de falhas ˜
Implementaçao, em ˜ | software, do modulo de injeç ´ | ao de falhas. ˜

Testes finais

Apos o projeto pronto, ´ | e necess ´ | ario fazer testes finais a fim de garantir o correto funciona- ´
mento do mesmo. Caso necessario, nesta etapa ser ´ | a feito um novo prot ´ | otipo de ´ | hardware.

Painel TCC

Essa etapa resume-se em elaborar um painel como forma de apresentaçao do TCC. ˜

Volume final do TCC

Com todos os dados e resultados coletados e obtidos durante o desenvolvimento do estudo,

sera elaborado um documento que contenha todas as informaç ´ | oes referentes ao desenvol- ˜
vimento do projeto, com uma apresentaçao detalhada das t ˜ | ecnicas usadas, dificuldades ´

encontradas e resultados obtidos.

30

# 6 Consideraçoes Finais ˜

A complexidade de alguns equipamentos e sistemas impoe um alto n ˜ | ível de dificuldade du-
rante o processo de verificaçao e validaç ˜ | ao. A automatizaç ˜ | ao de testes pode ajudar muito em ˜
termos de determinismo, tempo de execuçao e confiabilidade do teste, por ˜ | em ela pode encontrar, ´
em alguns casos, entraves quanto a implementaç ` | ao da automatizaç ˜ | ao. ˜
O resultado esperado do projeto SFP ATE facilitara a validaç ´ | ao de ˜ | ethernet switches que
usam SFPs e homologaçao de SFPs. Apesar o projeto usar esse cen ˜ | ario como estudo de caso, ´
os conceitos e tecnicas utilizados podem ser aplicados em diversas ´ | areas onde um equipamento ´
principal trabalha em conjunto com equipamento secundario, ou perif ´ | erico. Essa generalizaç ´ | aõ

torna o projeto uma arma poderosa no teste funcional e validaçao de novos equipamentos. ˜

31

Referencias Bibliogr ˆ | aficas ´
DELAMARO, M. E.; MALDONADO, J. C.; JINO, M. Introduçao ao Teste de Software ˜ | . [S.l.]:
Elsevier, 2007.

HSUEH, M.-C.; TSAI, T. K.; IYER, R. K. Fault injection techniques and tools. Abril 1997.

PHY. 9 2013. Website. http://pt.wikipedia.org/wiki/PHY.

SFF COMMITTEE. INF-8074i. Rev 1.0. [S.l.], 2001. ftp://ftp.seagate.com/sff/ INF-8074.PDF.

SFF COMMITTEE. SFF-8472. Rev 11.3. [S.l.], 2013. ftp://ftp.seagate.com/sff/ SFF-8472.PDF.
