redivo/tcc/doc/project/volume-final/figuras/barramento_i2c.png

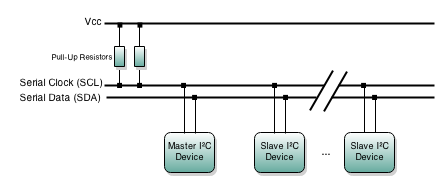
doc/project/volume-final/figuras/barramento_i2c.png
