redivo/tcc/doc/project/volume-final/figuras/hs-pcb.png

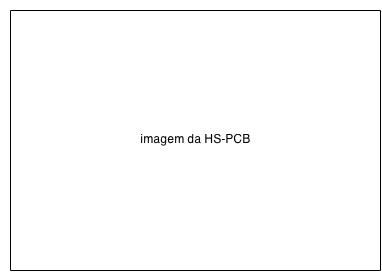
doc/project/volume-final/figuras/hs-pcb.png
