redivo/tcc/doc/project/hw/ls_pcb_layout_bot.pdf

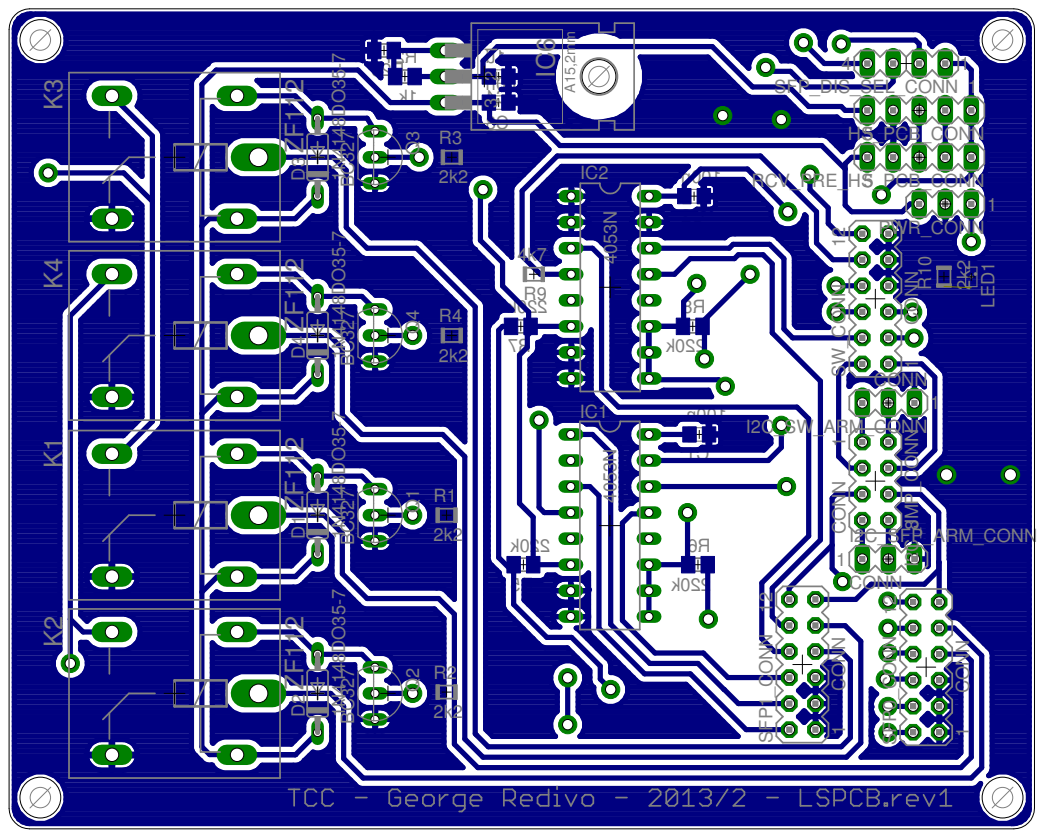
[picture p22: page 1]

k022 k022 k022 k022 n001 n001 n001 u1 2k1k1 6 R 5 R 8 R 7 R 1 C 2 C 3 C4 C 02 R12 R 1 12 1 12 1 11 8 4 1 1 12 1 A15,2mm 1 5 1 5 1 2 3 SFP0_CONN SFP1_CONN I2C_SW_ARM_CONN I2C_SFP_ARM_CONN I2C_JMP_CONN SFP_DIS_SEL_CONN IC1 IC2 SW_CONN PWR_CONN IC6 R1 D1 K1 Q1 R2 D2 K2 Q2 R3 D3 K3 Q3 R4 D4 K4 Q4 HS_PCB_CONN RCV_PRE_HS_PCB_CONN R9 R10 LED1 CONN CONN CONN CONN CONN4053N 4053N CONN 12k2 N4148DO35-7 ZF112 BC327 12k2 N4148DO35-7 ZF112 BC327 12k2 N4148DO35-7 ZF112 BC327 12k2 N4148DO35-7 ZF112 BC327 4k7 2k2
