redivo/tcc/doc/project/hw/ls_pcb_layout_top.pdf

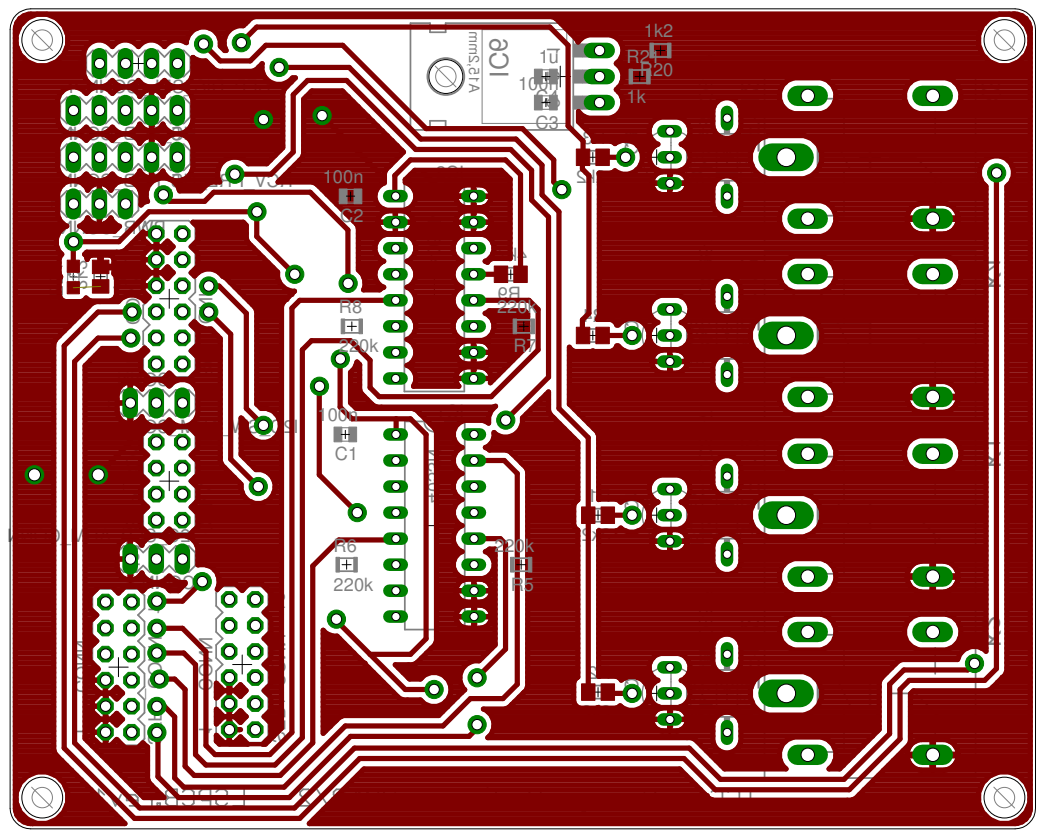
[picture p23: page 1]

CONN CONN NNOCNNOCCONN4053N 4053N CONN 2k2 1N4148DO35-7 ZF112 BC327 2k2 1N4148DO35-7 ZF112 BC327 2k2 1N4148DO35-7 ZF112 BC327 2k2 1N4148DO35-7 ZF112 BC327 7k4 2k2 SFP0_CONN SFP1_CONN NNOC_ MRA_ WS_ C2I NNOC_ MRA_PFS_ C2I I2C_JMP_CONN NNOC_LES_SI D_PFS 1 CI 2 CI SW_CONN NNOC_ R WP IC6 1 R D1 K1 Q1 2 R D2 K2 Q2 3 R D3 K3 Q3 4 R D4 K4 Q4 NNOC_BCP_SH NNOC_BCP_SH_ERP_VCR 9 R R10 LED1 1 2 3 1 12 1 12 1 11 8 1 4 1 12 1 A15,2mm 11 55 R6 R5 R8 R7 C1C2 C3 C4 R20 R21 220k 220k 220k 220k 100n 100n 100n1u 1k2 1k
