redivo/tcc/doc/project/hw/ls_pcb_schematic.pdf

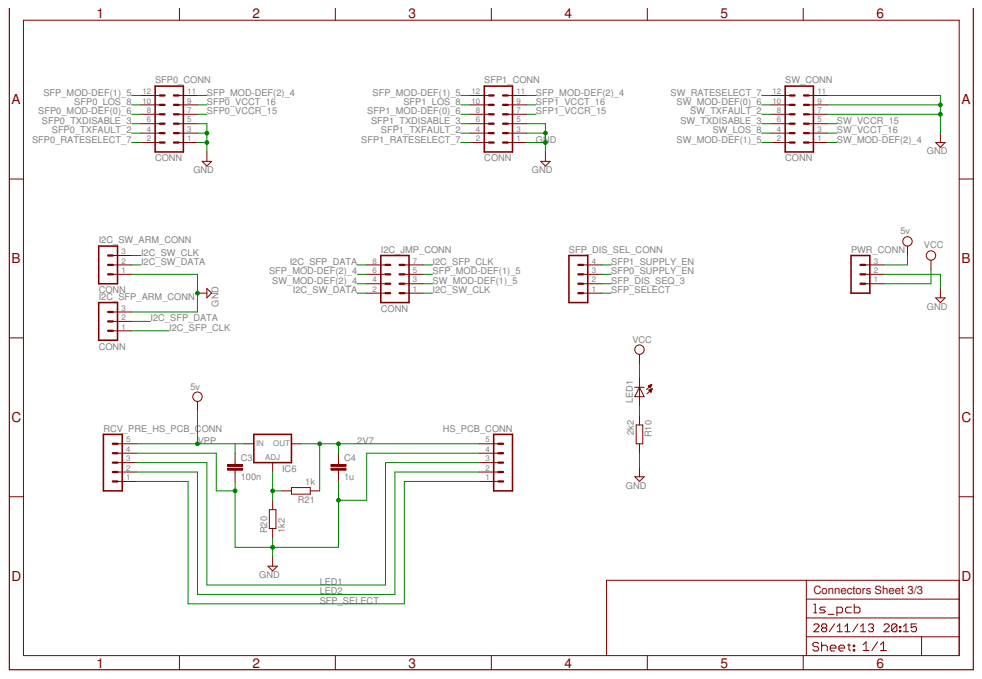
[picture p24: page 1]

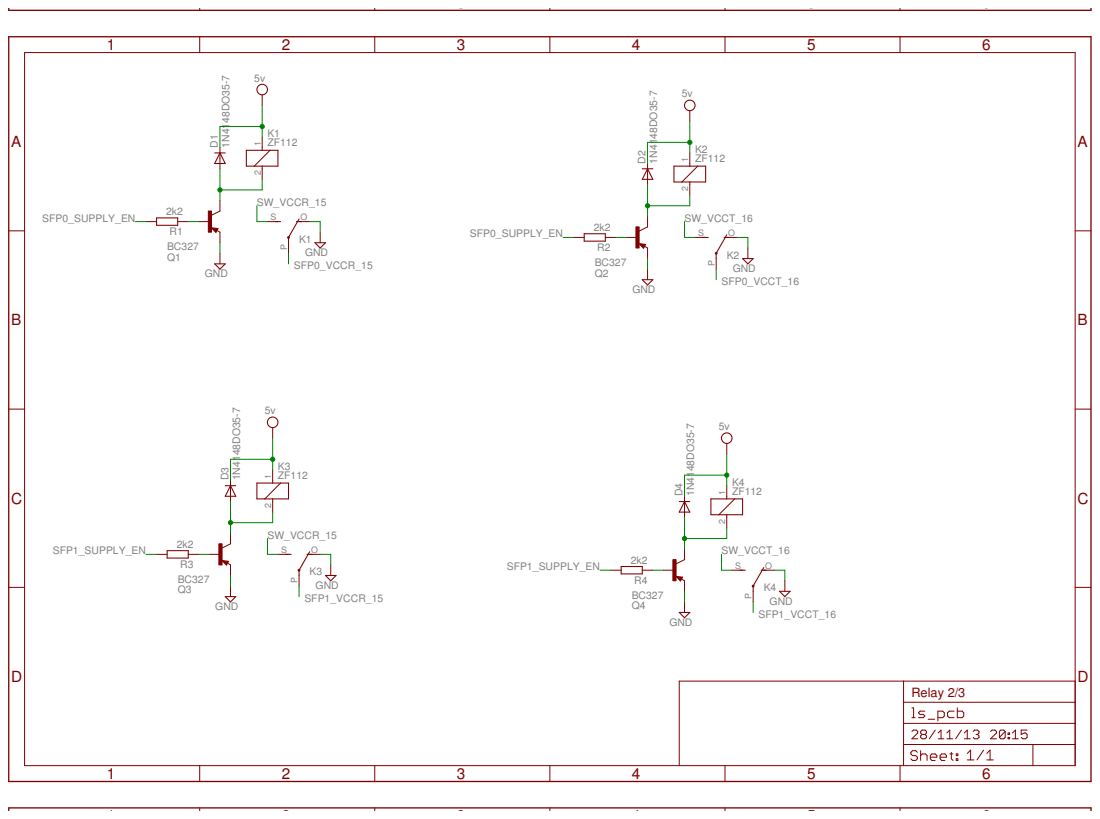
[picture p25: page 2]

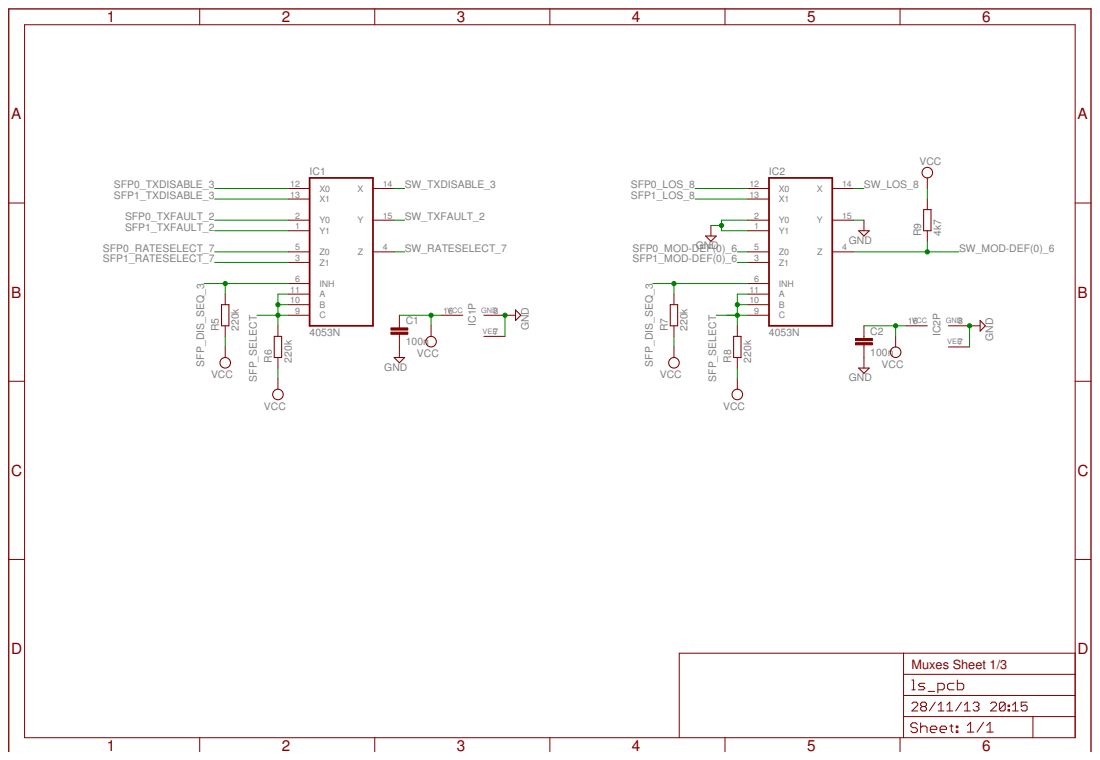
[picture p26: page 3]
