redivo/tcc/doc/project/hw/hs_pcb_schematic.pdf

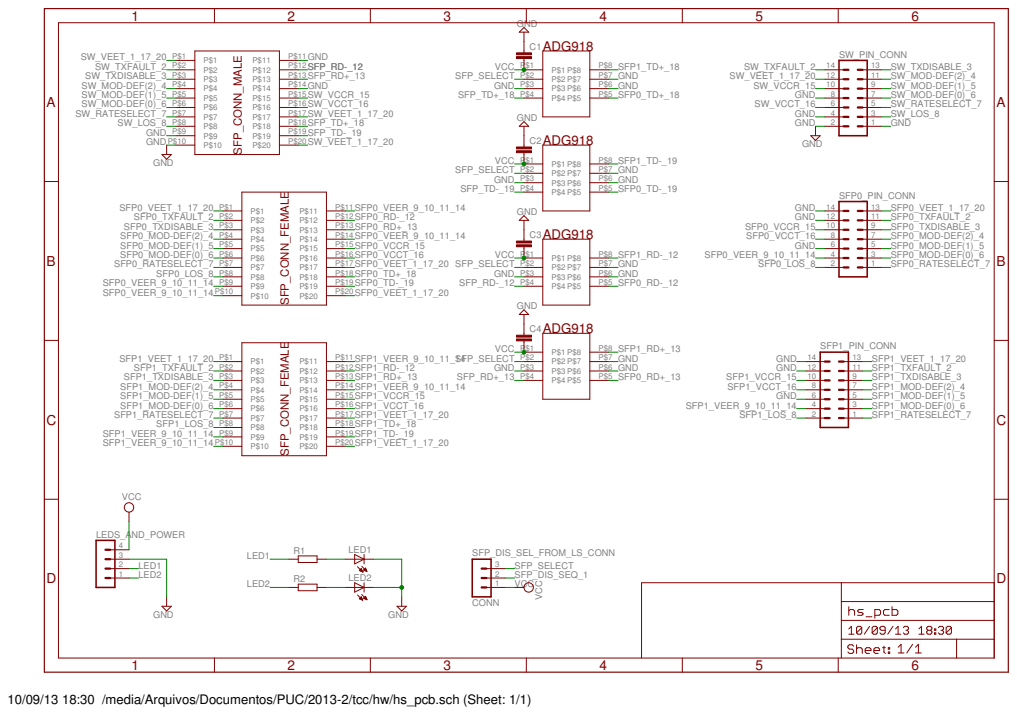
[picture p27: page 1]

10/09/13 18:30 /media/Arquivos/Documentos/PUC/2013-2/tcc/hw/hs_pcb.sch (Sheet: 1/1)
