redivo/tcc/doc/project/volume-final/figuras/normal_operation.pdf

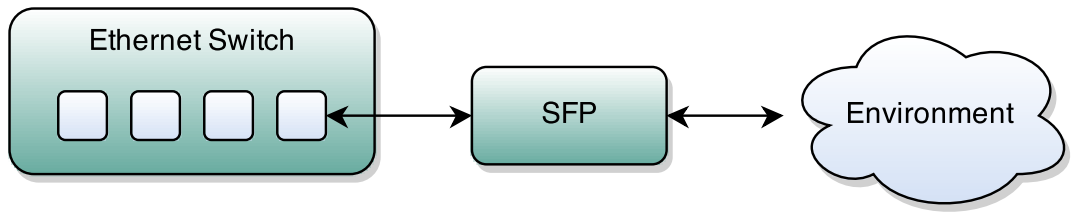
[picture p28: page 1]
