redivo/tcc/doc/project/hw/hs_pcb_layout_bot.pdf

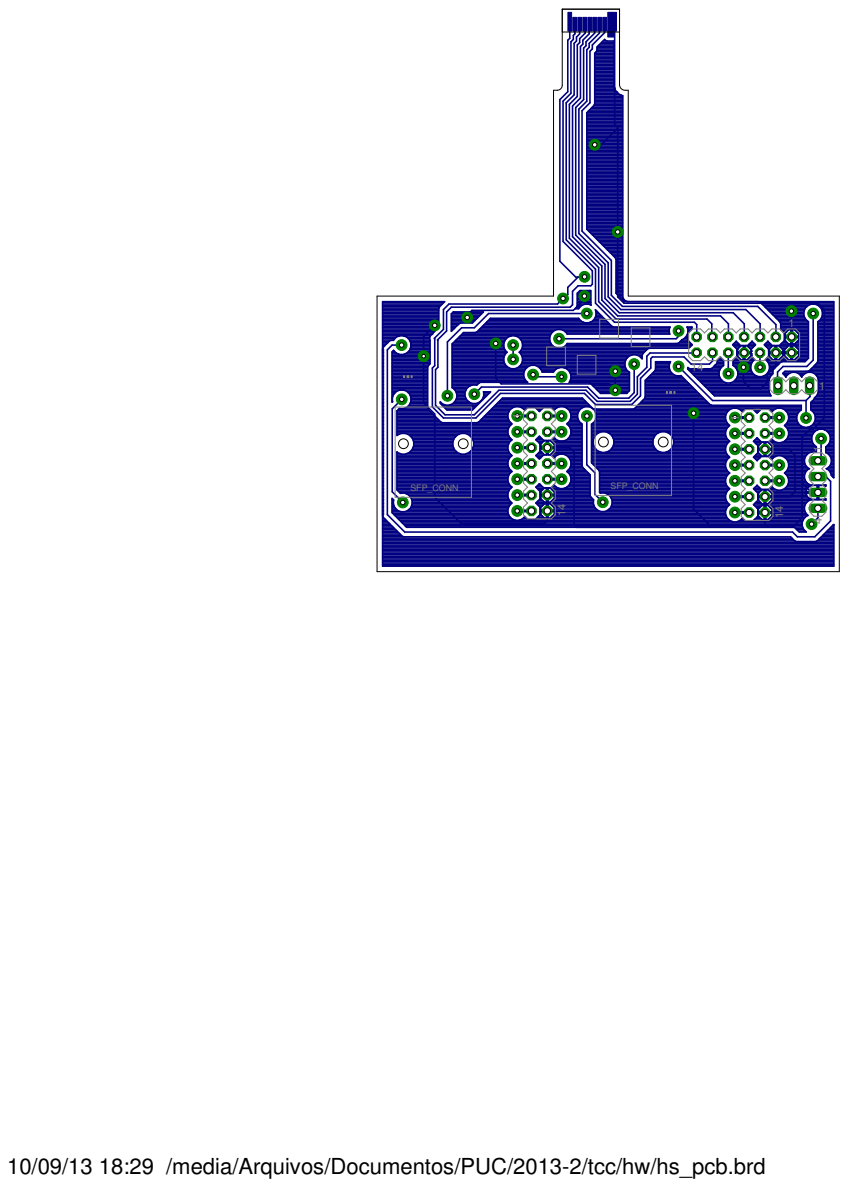
[picture p29: page 1]

10/09/13 18:29 /media/Arquivos/Documentos/PUC/2013-2/tcc/hw/hs_pcb.brd
