redivo/tcc/doc/project/hw/hs_pcb_layout_full.pdf

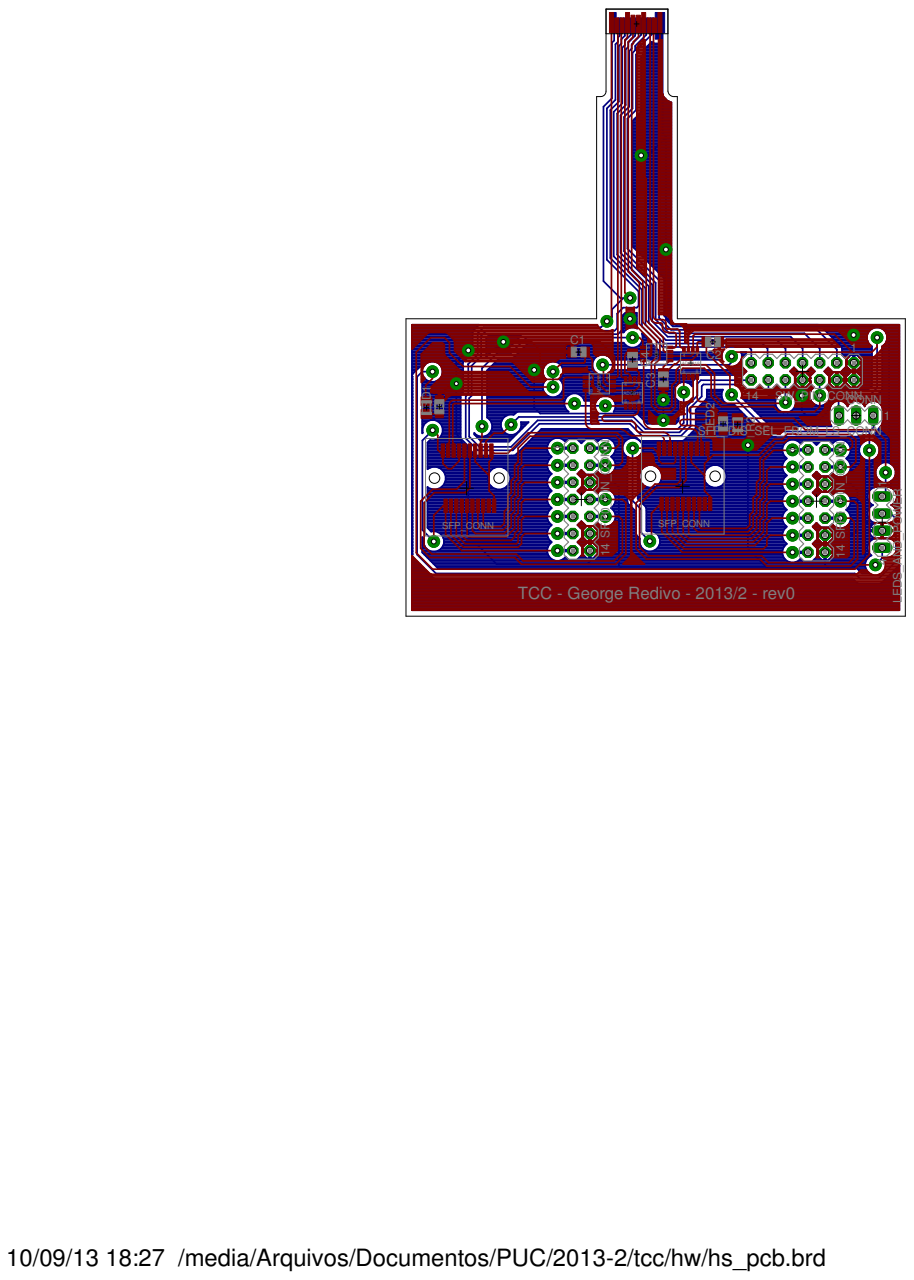
[picture p30: page 1]

5 8 ADG918 4 1

SFP_CONN | SFP_CONN

10/09/13 18:27 /media/Arquivos/Documentos/PUC/2013-2/tcc/hw/hs_pcb.brd
