redivo/tcc/doc/project/hw/hs_pcb_layout_top.pdf

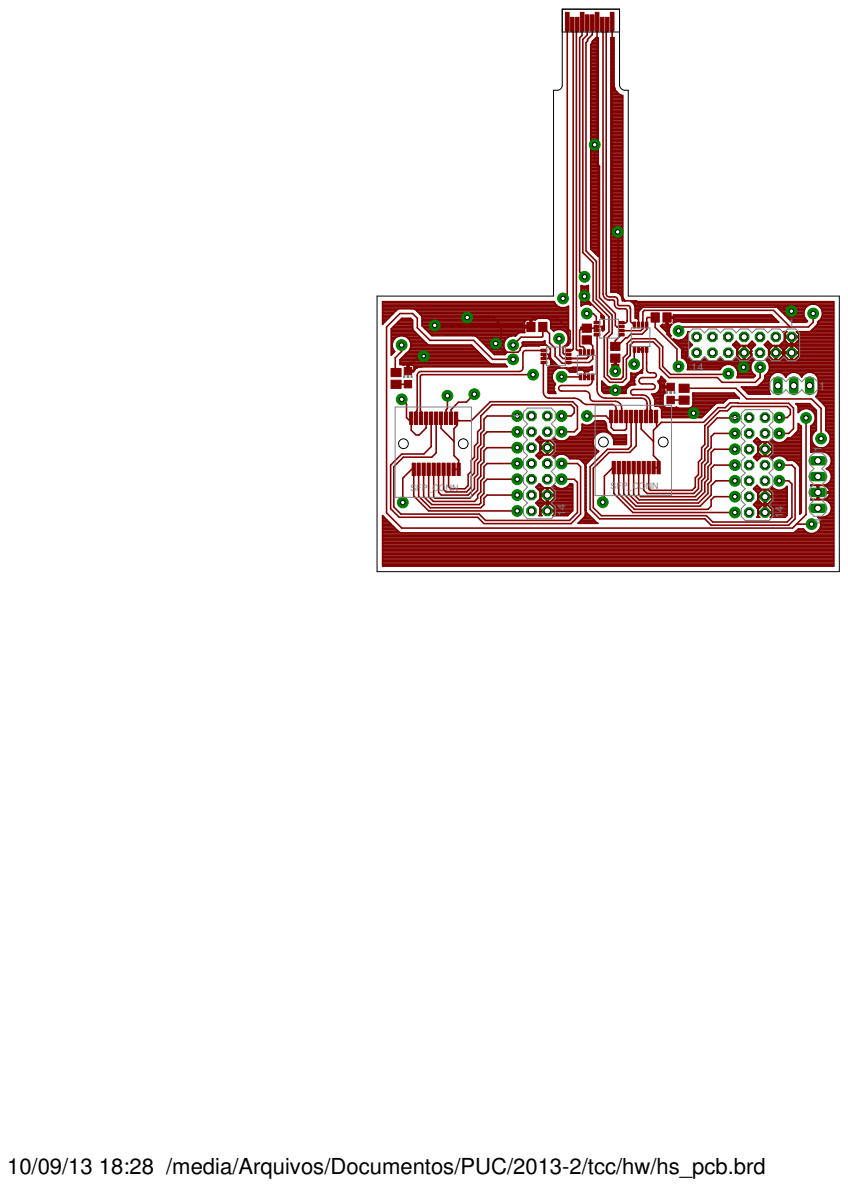
[picture p31: page 1]

10/09/13 18:28 /media/Arquivos/Documentos/PUC/2013-2/tcc/hw/hs_pcb.brd
