redivo/tcc/doc/project/volume-final/figuras/arq-sw.pdf

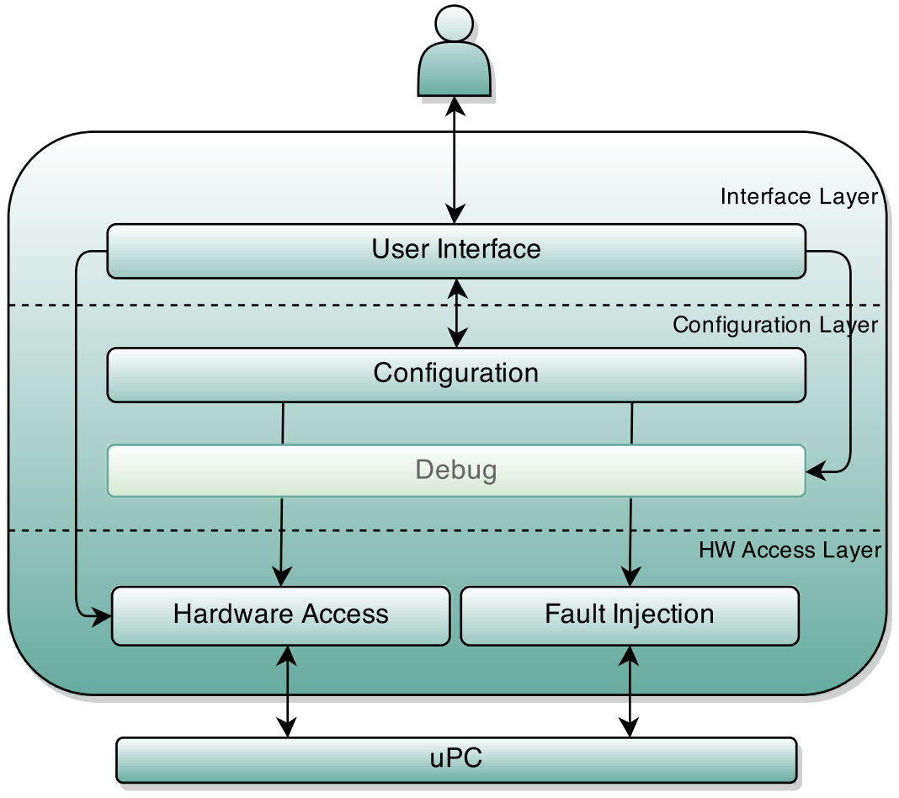
[picture p32: page 1]
