redivo/tcc/doc/project/volume-final/figuras/ate_i2c_linkage.pdf

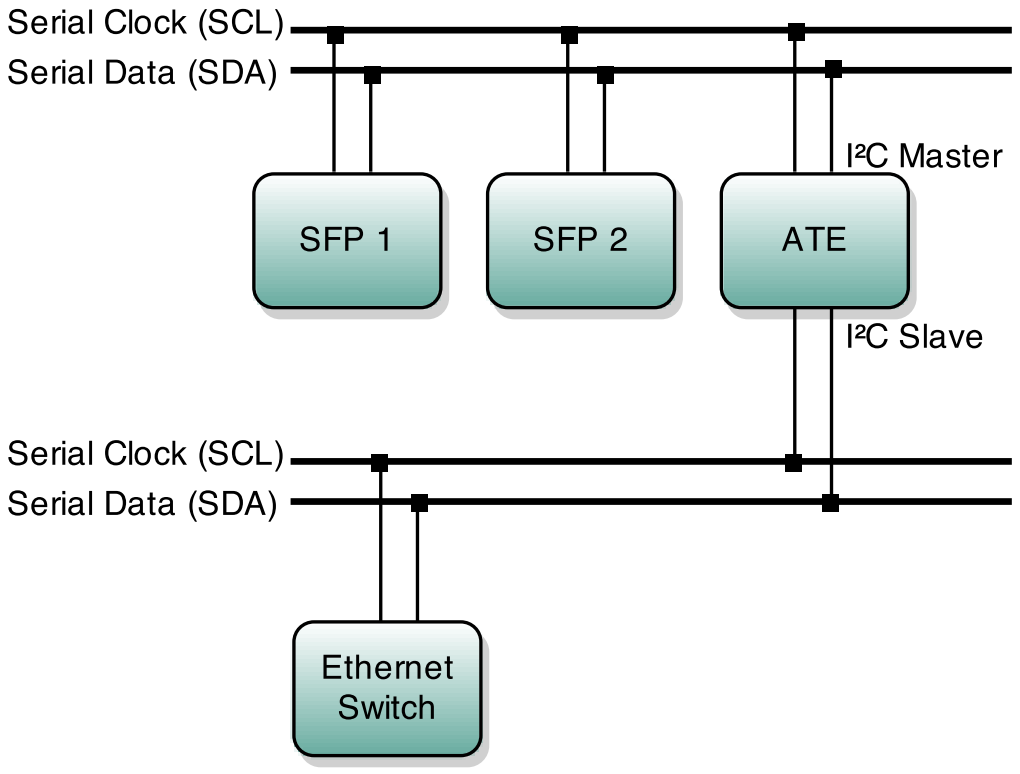
[picture p33: page 1]
