redivo/tcc/doc/project/volume-final/figuras/ate_mux.pdf

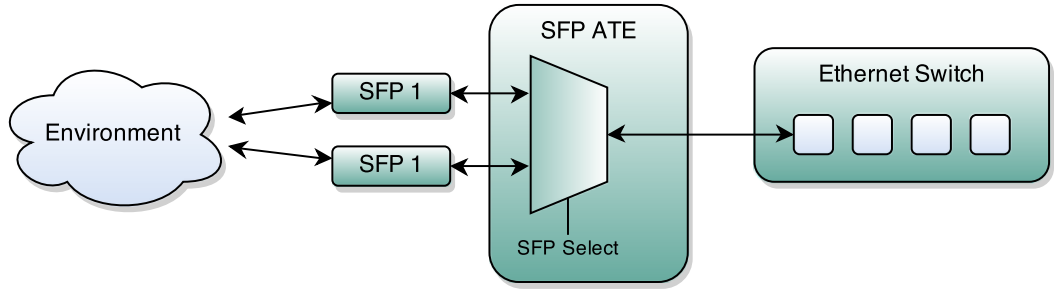
[picture p34: page 1]
