redivo/tcc/doc/project/volume-final/figuras/complete_ate.pdf

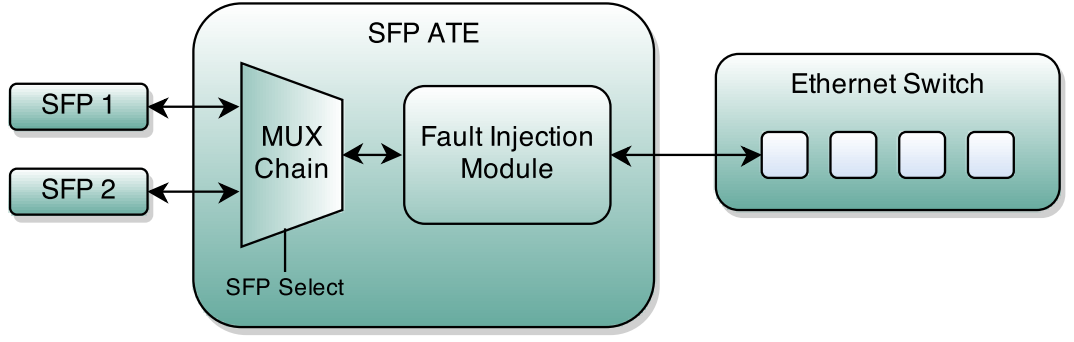
[picture p35: page 1]
