redivo/tcc/doc/project/volume-final/figuras/fault_injection.pdf

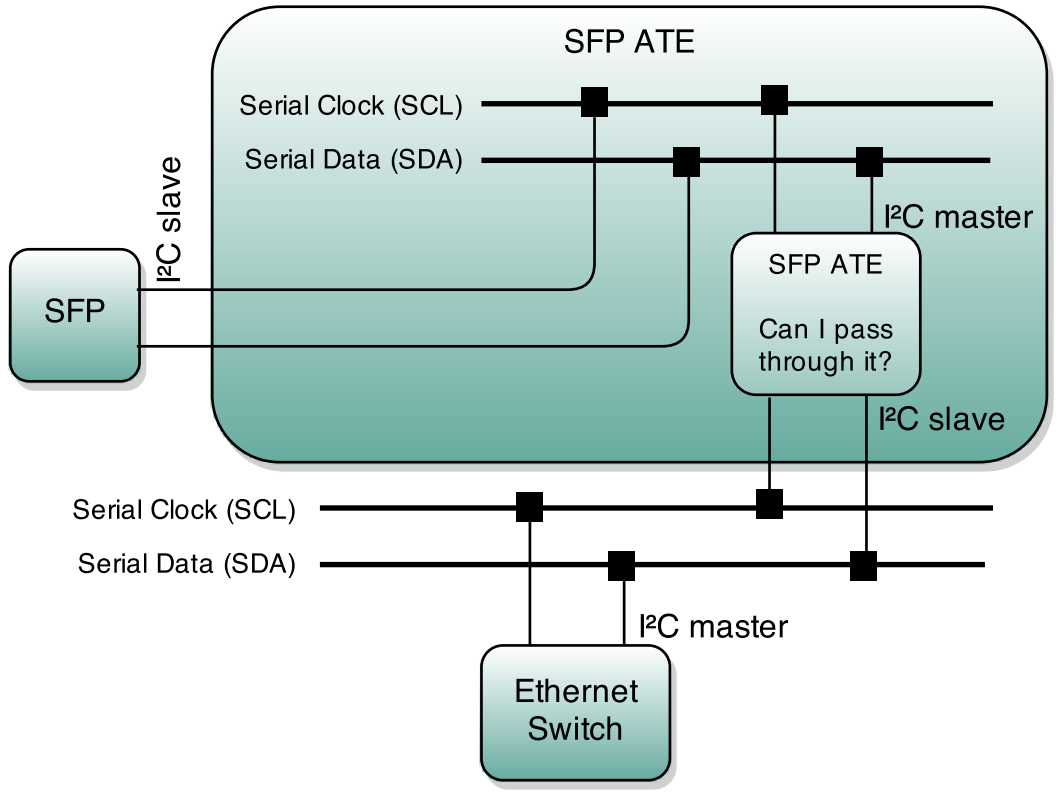
[picture p36: page 1]
