redivo/tcc/doc/project/volume-final/figuras/hw.pdf

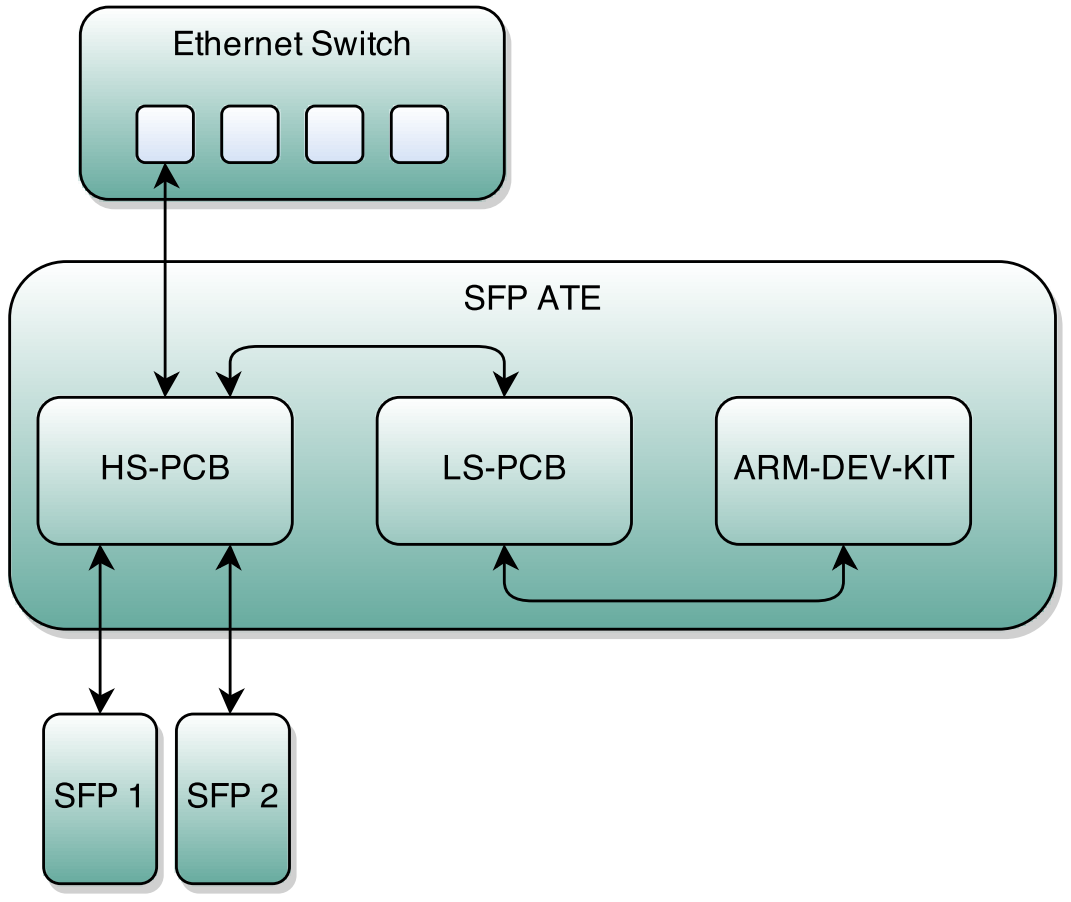
[picture p37: page 1]
