redivo/tcc/doc/project/volume-final/figuras/i2c_bus.pdf

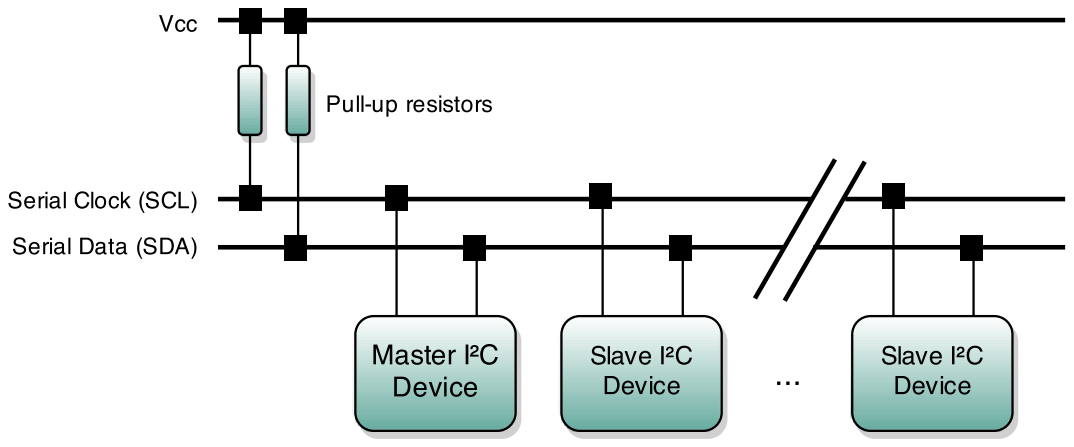
[picture p38: page 1]
