redivo/tcc/doc/project/volume-final/figuras/ls-pcb-blocos.pdf

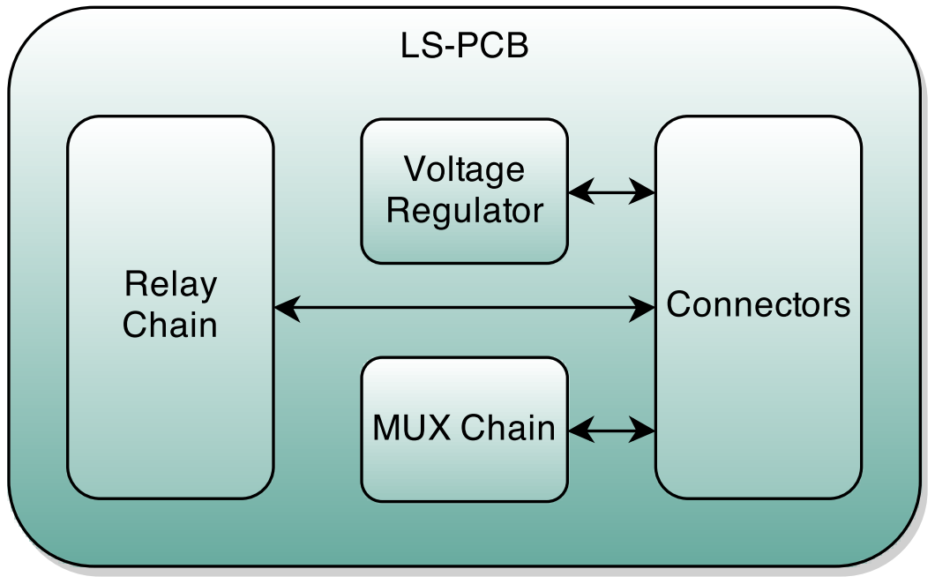
[picture p39: page 1]
