redivo/tcc/doc/project/volume-final/figuras/phy_combo.pdf

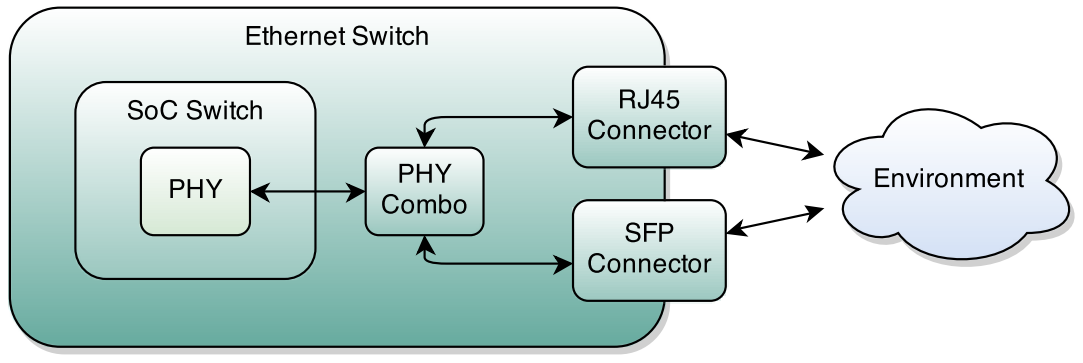
[picture p40: page 1]
