redivo/tcc/doc/project/volume-final/figuras/phy_electrical_sfp.pdf

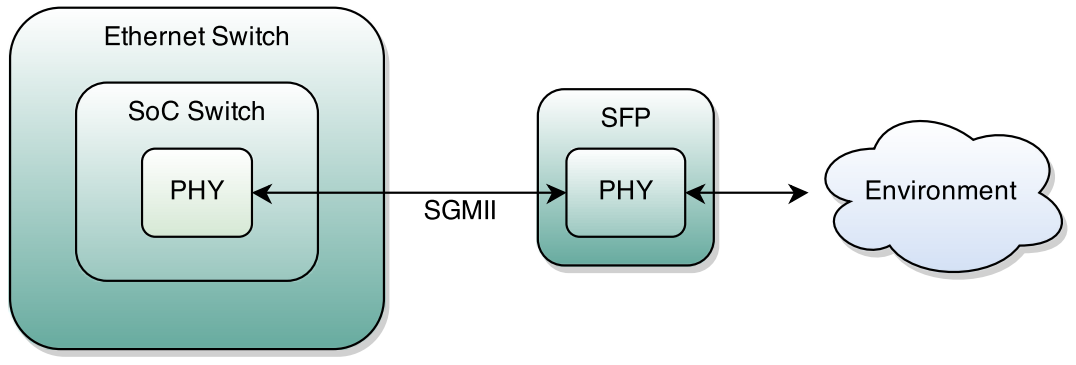
[picture p41: page 1]
