redivo/tcc/doc/project/volume-final/figuras/phy_pass_through.pdf

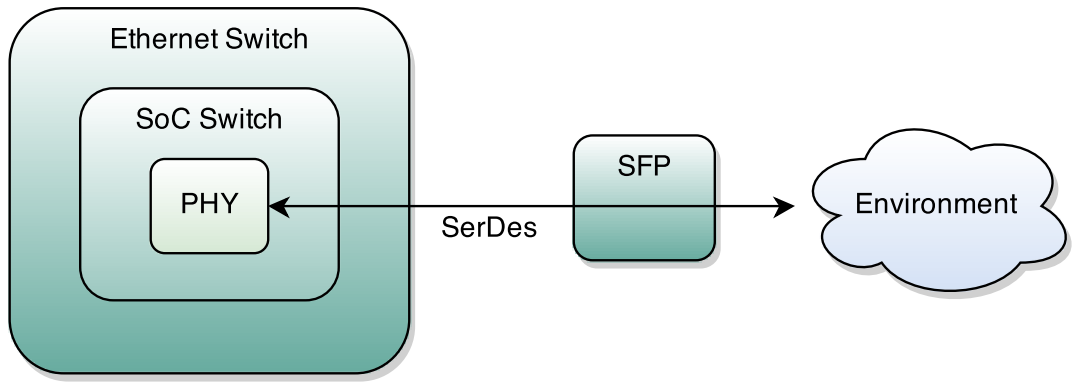
[picture p42: page 1]
