redivo/tcc/(commit log)

2013-10-11 [SW] Basic suppport.
    Basic support to the system.
    Debug mode, ARM compilation, PC compilation.
    Basic CLI.
2013-11-02 [HW] LS-PCB and HS-PCB rev0.
    Reference documentation;
    Project documentation;
    CAM files;
    LS-PCB and HS-PCB schematic and layout;
    Create SFP and Analog devices lib.
    Conflicts:
    .gitignore
    [hs_pcb.brd, hs_pcb.sch, ls_pcb.brd, ls_pcb.sch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]
2013-11-28 [HW] LS-PCB revision 1.
    Revision of LS-PCB:
    - Include relay chain;
    - Now some MUXes are unnecessary, so remove them;
    - Turn I²C connection to bus, not MUX anymore;
    - Reorganize I/O pins;
    - Include voltage regulator.
    Remove CAM files and mirrored layouts.
    Update LS-PCB documentation (PDFs).
    [ls_pcb.brd, ls_pcb.sch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]
